julian0821/KAIOS/CANSAT/DOCUMENTACION/CANSAT - KAIOS/PDR de terceros/PDR06.pdf

Team Logo
Here

# CanSat 2014 Preliminary Design Review (PDR) Outline

#5524

# ARISAT

### (ISTANBUL TECNICAL UNIVERSITY)

CanSat 2014 PDR: Team #5524 (Team ARISAT) | 1

# (If You Want) Presentation Outline

- Systems Overview | 6 (Hasbi Sevinç)

## - Sensor Susbsystem Design | 20 (Mert Kahyaoğlu)

- Descent Control Design | 29 (Nazmi Erdi COŞKUNPINAR)
- Mechanical Subsystem Deign | 39 (Ümit Yelken)
- Communication & Data Handling | 51 (Caner BALYEMEZLER)
- Electrical Power System Design | 62 (Emre Erbuğa)
- Flight Software Design | 76 (Emre Erbuğa)
- Ground Control Control System Design. | 83 (Ali Canpolat)
- Cansat Integration and Test | 90 (Ümit Yelken)
- Mission Operation and Analysis | 95 (Eren Durkaya)
- Requirements Compliance | 100 (Eren Durkaya)
- Management | 112 (Hasbi Sevinç)
Presenter: Hasbi Sevinç | CanSat 2014 PDR: Team #5524 (Team ARISAT) | 2

(If You Want) | Team ARISAT
Name | Year | Department
Hasbi Sevinc | Junior | Electronic and Communication Engineering
Ali Canpolat | Senior | Electronic and Communication Engineering
Eren Durkaya | Freshman | Astronautical Engineering
Caner Balyemezler | Senior | Electronic Engineering
Emre Erbuga | Freshman | Control Engineering
Umit Yelken | Junior | Mechanical Engineering
Mert Kahyaoglu | Junior | Electronic and Communication Engineering
Nazmi Erdi Coskunpinar | Junior | Astronautical Engineering
Presenter: Hasbi Sevinç | CanSat 2014 PDR: Team #5524 (Team ARISAT) | 3

# (If You Want) Team Organization

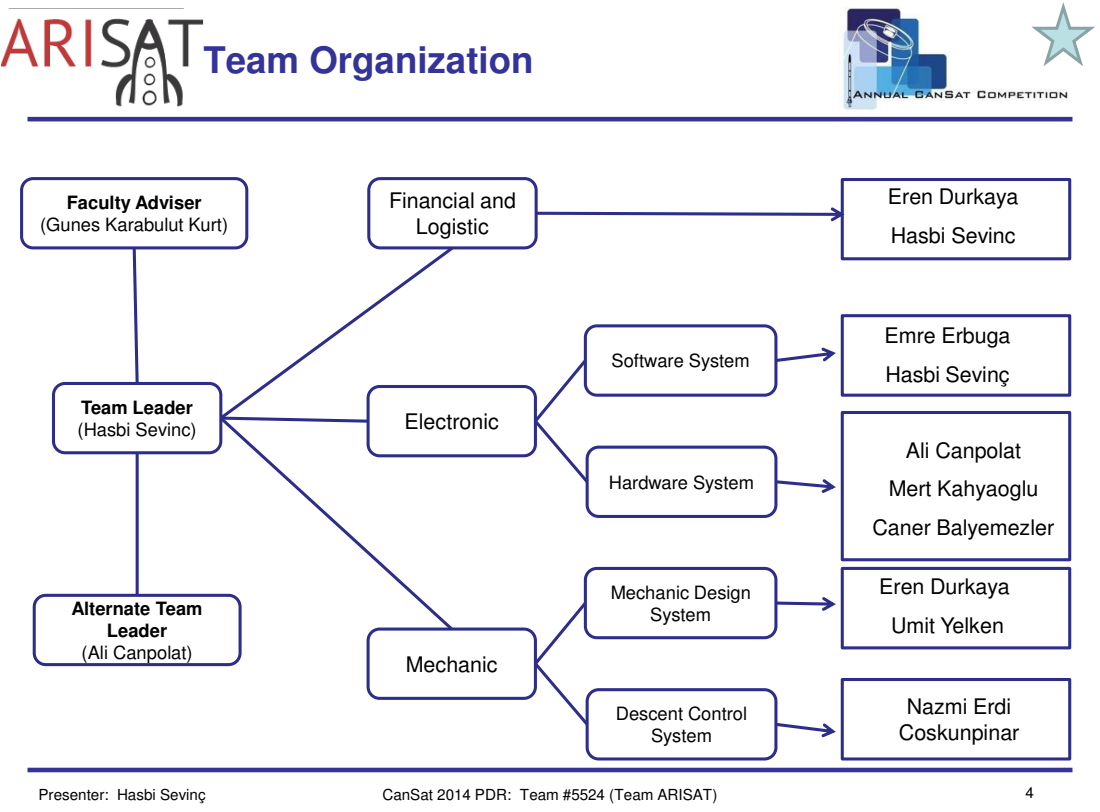
[picture p3: page 4]
Presenter: Hasbi Sevinç; CanSat 2014 PDR: Team #5524 (Team ARISAT); Team Leader (Hasbi Sevinc); Alternate Team Leader (Ali Canpolat); Financial and Logistic; Electronic; Mechanic; Software System; Hardware System; Mechanic Design System; Descent Control System; Eren Durkaya; Hasbi Sevinc; Emre Erbuga; Hasbi Sevinç; Ali Canpolat; Mert Kahyaoglu; Caner Balyemezler; Umit Yelken; Nazmi Erdi Coskunpinar

Faculty Adviser
(Gunes Karabulut Kurt)

(If You Want)

CanSat 2014 PDR: Team #5524 (Team ARISAT) | 5

# Acronyms

A – Analysis

ADC – Analog-to-Digital Converter

ADR – Average Descent Rate

ALT - Altitude
CDH – Communication & Data Handling

D – Demonstrate

DCD – Descent Control Design

DCS – Descent Control System

DS – Datasheet

EEPROM – Electrically Erasable Programmable Read-Only Memory
EPS – Electric Power System

F- Figure
FSW – Flight Software

GCS – Ground Control System

GPS – Global Positioning System

I – Inspect

I2C – Inter-Integrated Circuit

MSR- Mechanica System Requirements

SR-System Requirements
SSR – Sensor Subsystem Requirements

T – Test

TEM – Temperature

UART– Universal synchronous asynchronous receiver/transmitter
VM – Verification Matrix

Presenter: Hasbi Sevinç

# Systems Overview

# Hasbi Sevinç

CanSat 2014 PDR: Team #5524 (Team ARISAT) | 6

# (If You Want) Mission Summary

## The Main object:

- The 2014 mission simulates a sensor payload traveling through a planetary atmosphere sampling the atmospheric composition during descent.

## Other Objectives:

- Cansat shall collect data using sensors. (pressure, temperature, altitude…)
- Cansat shall transmit telemetry data’s to ground station.
- Protecting the egg.
- The descent rate of the CanSat shall be 12 m/s above 500 meters.
- Container shall release the payload at 500 meters.
- After releasing, the payload shall have a descent rate of less than 10 m/s.
- Payload must control descent rate without using parachute

## Bonus Objective:

- Use a three-axis accelerometer to measure the stability and angle of descent of the payload during descent. Sample at appropriate rate and store data for later retrieval.
- We decided to choose first bonus because measuring light intensity requires new subsystem. Our system already capable of measuring stability and angle of descent
Presenter: Hasbi Sevinç | CanSat 2014 PDR: Team #5524 (Team ARISAT) | 7

(If You Want) | System Requirement Summary
ID | Requirement | Rationale | Priority | Parent(s) | Children | VM
A | I | T | D
SRS-01 | Total mass of the CanSat shall not exceed 600 grams without the egg. | Competition Rule | HIGH | | MSR-01 | | X
SRS-02 | Cansat will be suited into cylindrical envelope at 125 mm diameter and 310 mm in length. | Competition Rule | HIGH | | MSR-04 | | X
SRS-03 | Payload suppose to harvest energy and also control descent rate without using parachute | Competition Requirement | HIGH | | EPS-01 | X X
SRS-04 | CanSat shall not use any flammable or pyrotechnic devices | Mission requirement to display real-time data. | HIGH | | DSC-02 | | X
SRS-05 | Cansat system and egg shall be recovered safely | Competition Rule | HIGH | | MSR-02 | | | X
Presenter: Hasbi Sevinç | CanSat 2014 PDR: Team #5524 (Team ARISAT) | 8

(If You Want) | System Requirement Summary
ID | Requirement | Rationale | Priority | Parent | Children | VM
A | I | T | D
SRS-06 | Cansat communication radio shall be the XBEE radio model and shall not use the broadcast mode | Competition Rule | HIGH | | CDH-01 | X | X
SRS-07 | Each team must use their own ground station | Competition Requirement | HIGH | | GCS -01 | | X
SRS-08 | All descent control systems must be capable of handling a 30G shock force | Competition Rule | HIGH | | DSC-06 DSC-07 | | X
SRS-09 | The cost of the Cansat shall not exceed $1000 USD. | Competition Rule | HIGH | | | X | X
SRS-10 | Use a three-axis accelerometer to measure the stability and angle of descent of the payload during descent | Bonus mission | MEDIUM | | SSD-04 | | | X
Presenter: Hasbi Sevinç | CanSat 2014 PDR: Team #5524 (Team ARISAT) | 9

(If You Want)

# System Level CanSat Configuration Trade & Selection

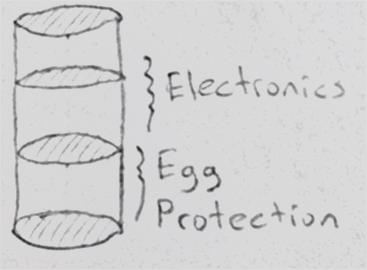
[picture p4: figure]

### - Round Design: First we consider a round design for payload, but this design ended up having area problem with energy harvesting system. We need to use flexiable solar panel which is unadaptable

for energy harvesting system.

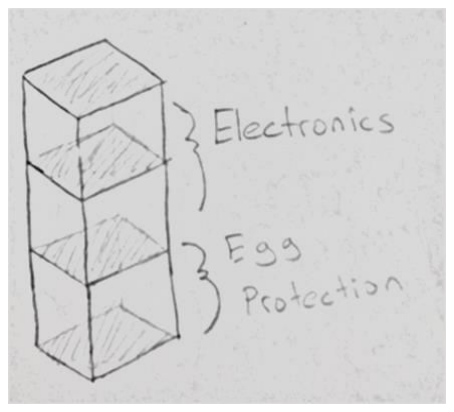
[picture p5: figure]

### - Square Design: Solar panels can be integrated easly, however this design could cause separation

problem between payload and container.

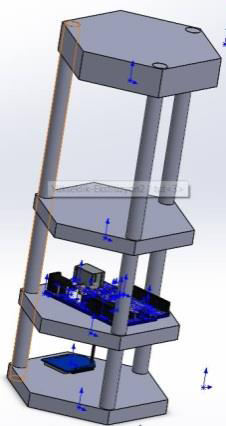
[picture p6: figure]

## - Hexagon Design (selected): This design

### provides enough area for electronic systems. Edge of hexagon has enough field to stick energy harvesting system. We think this is the best way for this years competition concept because harvesting

energy is a big deal for structure type.

Presenter: Hasbi Sevinç | CanSat 2014 PDR: Team #5524 (Team ARISAT) | 10

(If You Want)

# System Level CanSat Configuration Trade & Selection

- We decided to use carbon fiber as a material of lateral cover and base cover, because its light and sturdy against damages.

### - For Egg Protection: We have so many options for egg protection hence, we

### had narrow the options down. There was two 2 different material left for the tests: rubber and polyethylen-C70 composite sandwich structure foam. When we try to use rubber system we saw that rubber system is heavier than polyethylen-C70 composite sandwich structure foam system. Finally our egg

protection system is ready.

### - Separation : When we discussing about our separation system some thoughts

### came up for instance using a cap system, using a rail system, using a prestressed spring but they did not satisfied us we should not make any mistake

finally we compromise then we designed ring-clevis system.

Presenter: Hasbi Sevinç | CanSat 2014 PDR: Team #5524 (Team ARISAT) | 11

# (If You Want) System Concept of Operations

# Pre-launch

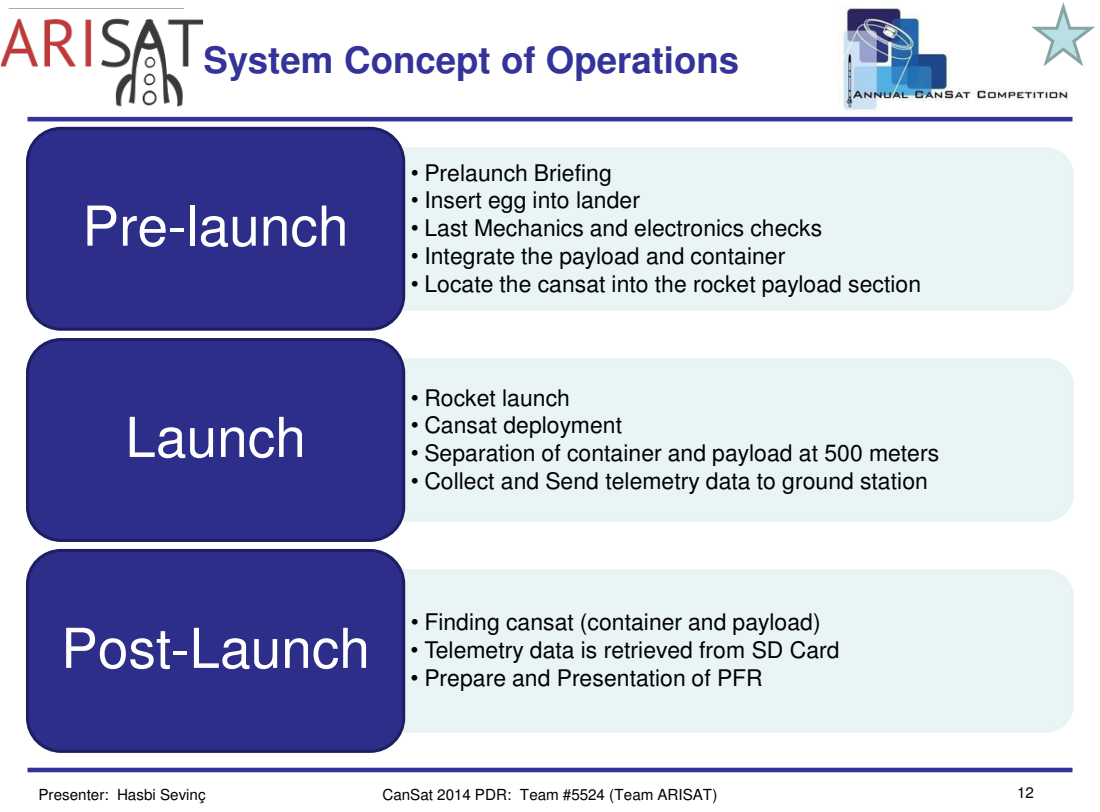
[picture p7: page 12]
Launch; Presenter: Hasbi Sevinç; CanSat 2014 PDR: Team #5524 (Team ARISAT)

• Prelaunch Briefing
• Insert egg into lander
• Last Mechanics and electronics checks
• Integrate the payload and container
• Locate the cansat into the rocket payload section

• Rocket launch
• Cansat deployment
• Separation of container and payload at 500 meters
• Collect and Send telemetry data to ground station

• Finding cansat (container and payload)

• Telemetry data is retrieved from SD Card Post-Launch

• Prepare and Presentation of PFR

(If You Want) | System Concept of Operations
| Launch and Descent Operations

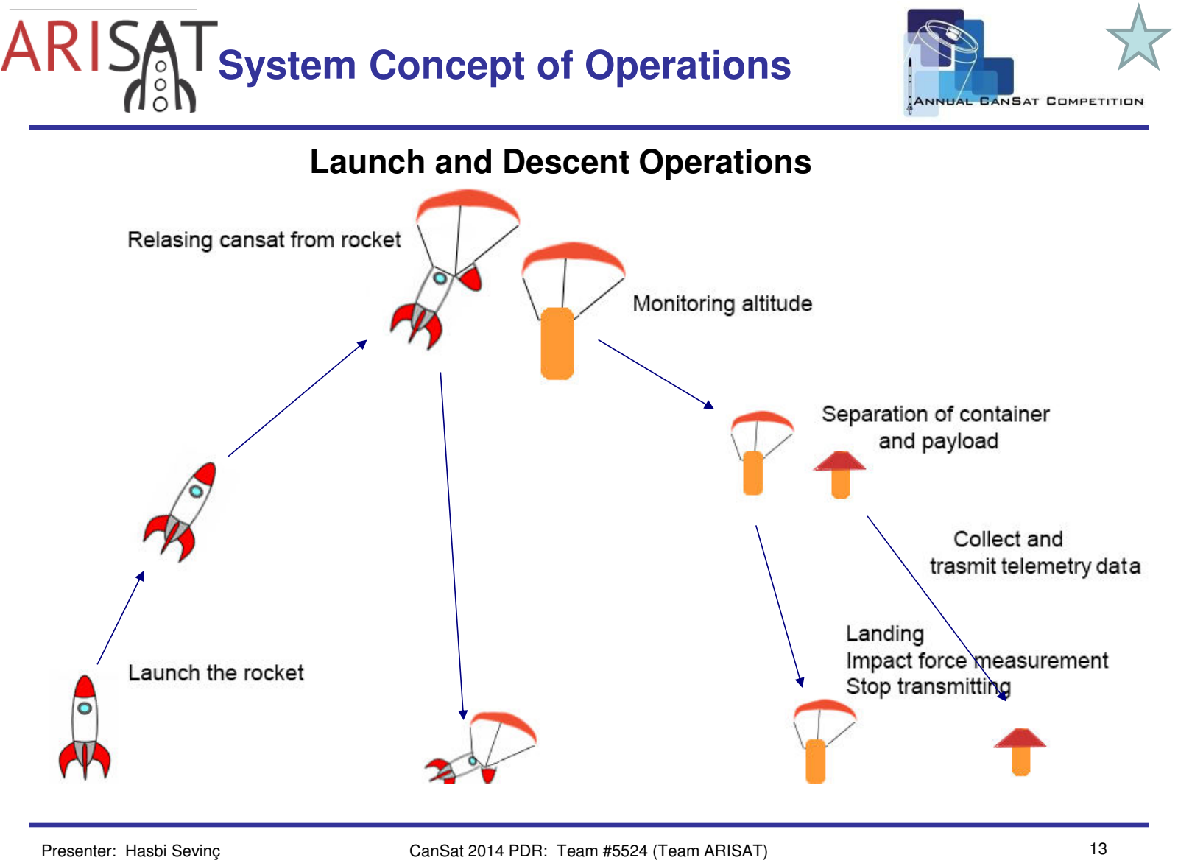
[picture p8: page 13]

Presenter: Hasbi Sevinç | CanSat 2014 PDR: Team #5524 (Team ARISAT) | 13

# (If You Want) System Concept of Operations

# Post-launch recovery

### - Find to landing location

### - Come back to ground station

### - Looking data which stored by payload via SD Card

# Post-launch data reduction

### - Infiltrate unpaired datas

### - Taking acceleration values

### - Compare ground station data with payload's for detect any differences

Presenter: Hasbi Sevinç | CanSat 2014 PDR: Team #5524 (Team ARISAT) | 14

(If You Want) | Physical Layout (Payload)

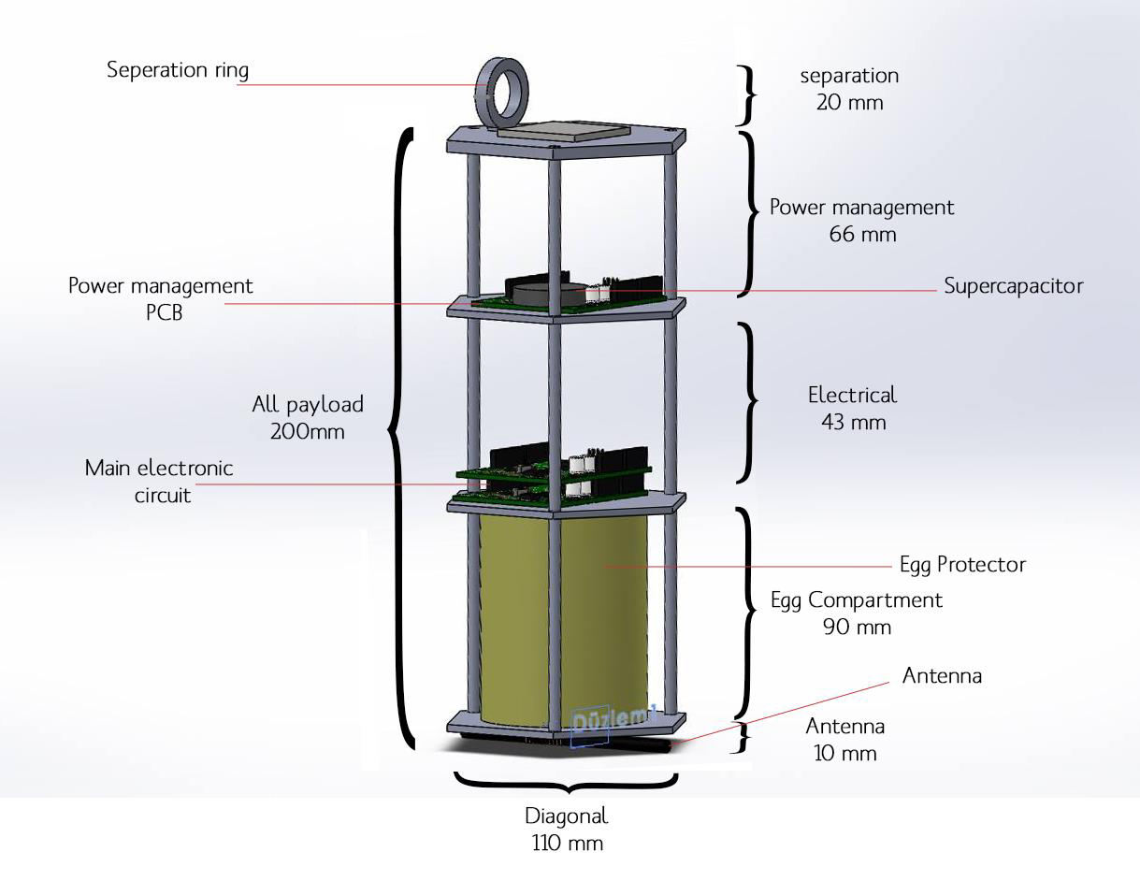
[picture p9: figure]

Presenter: Hasbi Sevinç | CanSat 2014 PDR: Team #5524 (Team ARISAT) | 15

(If You Want) | Physical Layout (Payload)

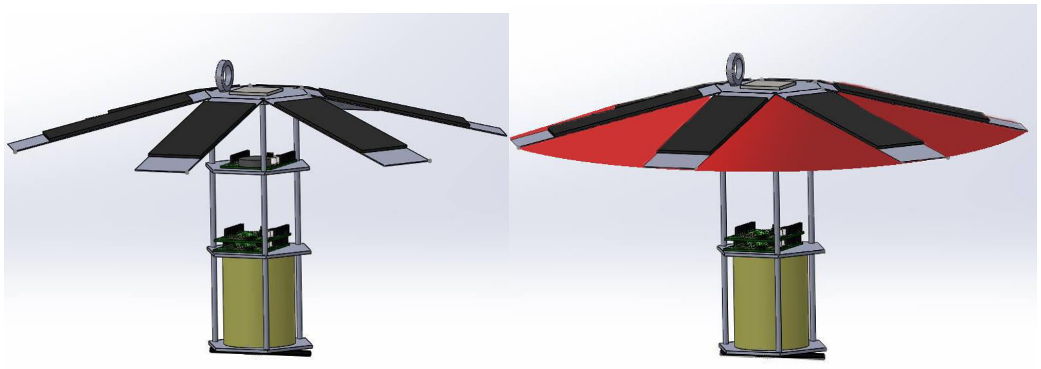
[picture p10: figure]

Presenter: Hasbi Sevinç | CanSat 2014 PDR: Team #5524 (Team ARISAT) | 16

## Payload with solar panels and descent system

# (If You Want) Physical Layout (Container)

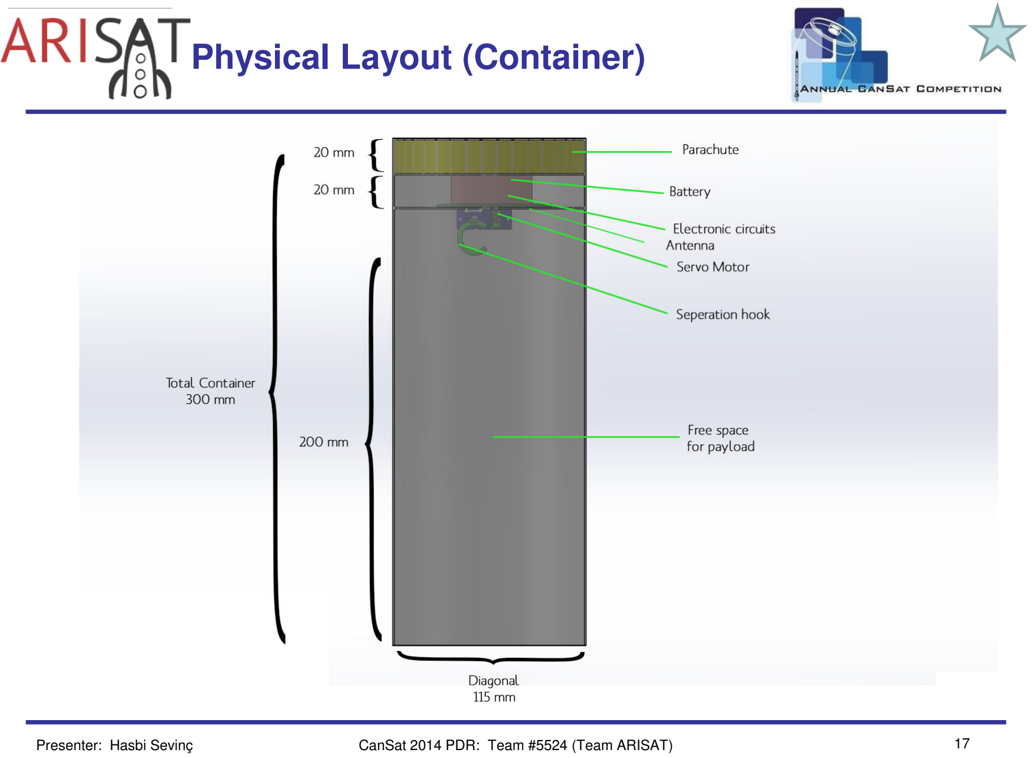
[picture p11: page 17]

Presenter: Hasbi Sevinç | CanSat 2014 PDR: Team #5524 (Team ARISAT) | 17

(If You Want) | Physical Layout (Payload + Container)

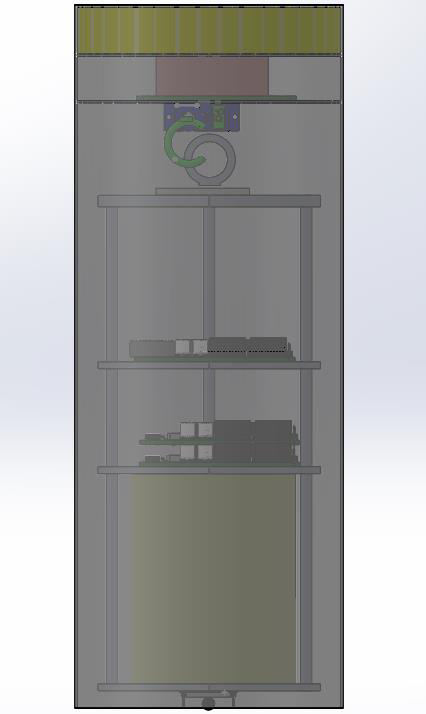
[picture p12: figure]

Presenter: Hasbi Sevinç | CanSat 2014 PDR: Team #5524 (Team ARISAT) | 18

(If You Want) | Launch Vehicle Compatibility

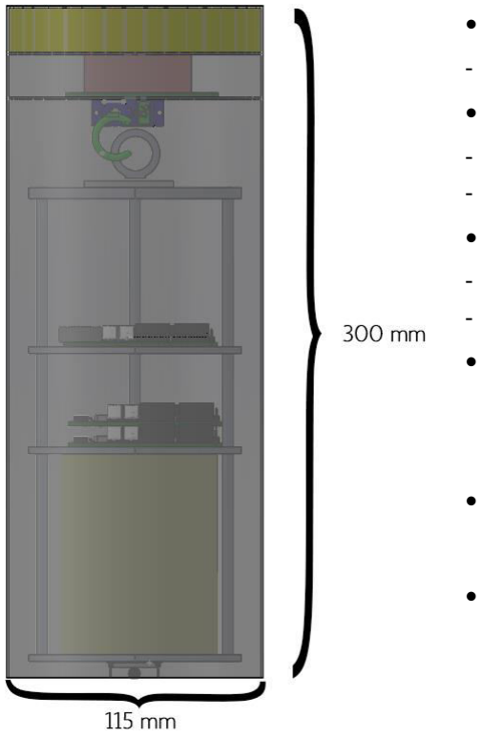
[picture p13: figure]

Presenter: Hasbi Sevinç | CanSat 2014 PDR: Team #5524 (Team ARISAT) | 19

## - Rocket payload dimensions:

- 125 mm x 310 mm

## - Cansat dimensions:

- Height: 300 mm
- Diameter: 115 mm

## - For a safety separation from rocket:

- leaving 5 mm of space on the top and bottom.
- leaving 5 mm of space on the left and right.

## - Cansat has a simple cylinder ic shape which disallowing any protrusions to

hinder ejection.

## - Before launch, cansat will test with a pre-built rocket payload model for verification - CanSat will be placed upside-down in rocket payload forDeployment from rocket correctly

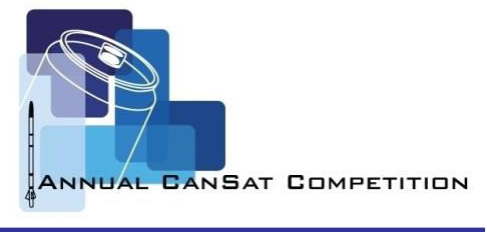
[picture p14: figure]

# Sensor Subsystem Design

# Mert Kahyaoğlu

CanSat 2014 PDR: Team #5524 (Team ARISAT) | 20

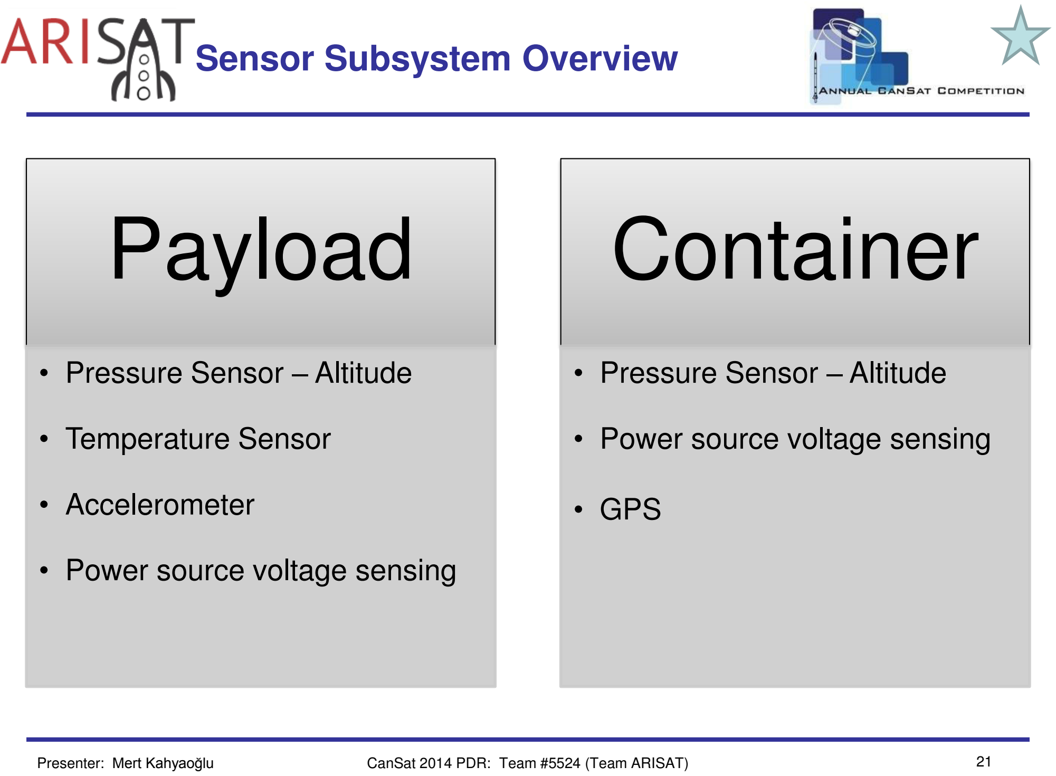
[picture p15: figure]
(If You Want); Sensor Subsystem Overview; Payload; • Pressure Sensor – Altitude; • Temperature Sensor; • Accelerometer; • Power source voltage sensing; Container; • GPS

Presenter: Mert Kahyaoğlu | CanSat 2014 PDR: Team #5524 (Team ARISAT) | 21

(If You Want) | Sensor Subsystem Overview
Sensor Type | Manufacture | Model | Purpose | CanSat use | Power Consumptioın
Pressure | Bosch | BMP-085 | Non-GPS Altitude measurement | Payload Container | 3.3v/5uA
Temperature | Bosch | BMP-085 | Temperature | Payload | 3.3v/5uA
Accelerometer | Analog Devices | ADXL345 | 3-Axis, ±2 g/±4 g/±8 g/±16 g Digital Accelerometer | Payload | 3.3v/40uA
Volt-meter | Atmel | Atmega2560 | Measurement of power source voltage | Payload Container | -
GPS | LOCOSYS Technology Inc | LS20031 | Descent Telemetry and determination of Landing | Container | 3.3v/41mA
Presenter: Mert Kahyaoğlu | CanSat 2014 PDR: Team #5524 (Team ARISAT) | 22

(If You Want) | Sensor Subsystem Requirements
ID | Requirement | Rationale | Priority | Parent | Children | VM
A | I | T | D
SSD-01 | Sensors must operate at 5V or less. | Our power system provide 5V or less | Medium | | EPS-05 EPS-04 | x
SSD-02 | All sensors must be able to sample data at a rate of at least 1 Hz | Base mission requirement | High | | FSW-01 | x | x
SSD-03 | Pressure sensor shall measure altitude with accuracy of at least 0.5 hPa | Base mission requirement | High | | | x | | x
SSD-04 | Accelerometer shall measure impact force at rate of at least 100 Hz | Base mission requirement | High | | | X
SSD-05 | Sensors shall use the following protocols: I2C, SPI, or Analog | Interface to Microcontroller | High | | | x | | X
Presenter: Mert Kahyaoğlu | CanSat 2014 PDR: Team #5524 (Team ARISAT) | 23

(If You Want) | Sensor Subsystem Requirements
ID | Requirement | Rationale | Parent | Children | Priority | VM
A | I | T | D
SSD-06 | Temperature sensor must have a range of at least 0ºC-50ºC | Air conditions of launch locatioın | High | | | x
SSD-07 | GPS Location data | Descent Telemetry and determination of Landing | High | | | x | x
Presenter: Mert Kahyaoğlu | CanSat 2014 PDR: Team #5524 (Team ARISAT) | 24

(If You Want) | Container GPS Trade & Selection
Model | Voltage/Current | Channel | Accuracy | Price | Weight
LS20031 GPS 5Hz Receiver | 3.3v/41mA | 66 | 3 | $59.95 | 14g
EM-408 | 3.3v/75mA | 20 | 10 | $60.00 | 16
MTK3339 10Hz | 3.3v/25mA | 20 | 2 | $39.95 | 8.5

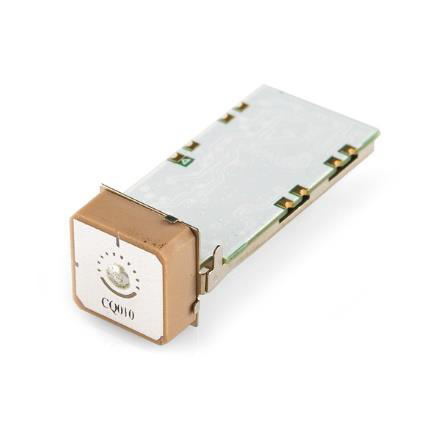
[picture p16: figure]

Presenter: Mert Kahyaoğlu | CanSat 2014 PDR: Team #5524 (Team ARISAT) | 25

LS20031 is selected, because;

### - Extremely compact - Internal antenna - High update rate - Low power consumption - Fast TTFF at low signal level

- Widely used, tested and examples.
- We use GPS therefore determination of container location after the landing.

(If You Want) | Altitude Sensor Trade & Selection
Model | Voltage/ Current | Range | Sample Rate(Hz) | Interface | Price | Weight
BMP085 | 3.3v/5uA | 30kPA-110kPa | 1 | I2C | $19.95 | 11g
SCP1000 | 3.3v/25u A | 30kPA-120kPa | 9 | SPI | $34.95 | 1.7g
MPL115A1 | 3.3v/10u A | 50kPa-115kPa | 1 | SPI | $11.95 | 2g

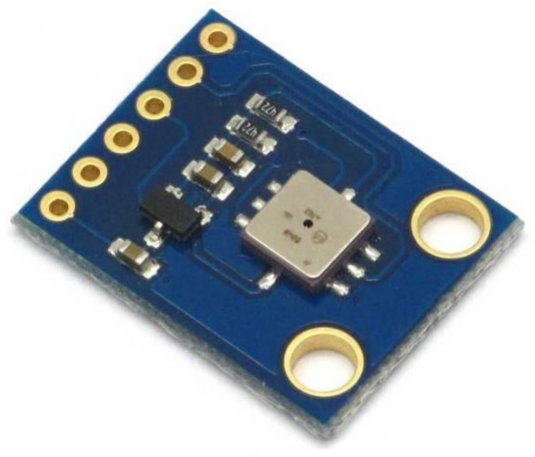
[picture p17: figure]

Presenter: Mert Kahyaoğlu | CanSat 2014 PDR: Team #5524 (Team ARISAT) | 26

BMP085 is selected for both payload and container.

### - Temperature measurement included - I2C interface - Fully calibrated

- Pb-free, halogen-free and RoHS compliant,

### - Ultra low power consumpiton - Altimeter accuracy of 0.25 [m] - Pressure Accuracy to ±0.2 [hPa]

(If You Want)

# Air Temperature Sensor Trade & Selection

Model | Voltage/ Current | Range | Sample Rate(Hz) | Interface | Price | Weight
BMP085 | 3.3v/5uA | -40º to +85ºC | 1 | I2C | $9.95 | 11g
SCP1000 | 3.3v/25u A | -20 to 70°C | 9 | SPI | $34.95 | 1.7g
MPL115A1 | 3.3v/10u A | -40°C to +105°C | 1 | SPI | $11.95 | 2g
DHT11 | 3.3v/200 uA | 0-50'C | 1 | Single Bus | $5.00 | 1.8g

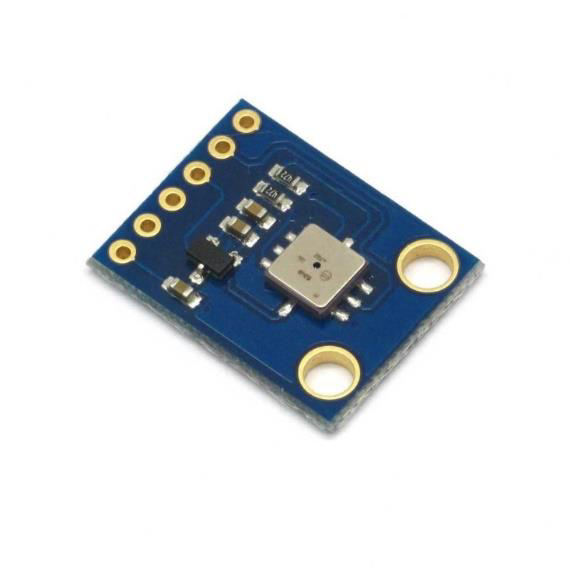
[picture p18: figure]

Presenter: Mert Kahyaoğlu | CanSat 2014 PDR: Team #5524 (Team ARISAT) | 27

### BMP085 is selected because:

### - Temperature measurement included - I2C interface - Fully calibrated

- Pb-free, halogen-free and RoHS compliant,

### - Ultra low power consumpiton - Temperature Accuracy to ±0.5 [ºC]

(If You Want)

# 3-Axis Accelerometer Sensor Trade & Selection

Model | Voltage/ Current | Range | Sample Rate(Hz) | Interface | Price | Weight
L3G4200D | 3.3v/6.7 mA | User Selectable ±250, ±500, ±2000 [dps] | 800Hz | I2C | $29.99 | 0.7 g
ADXL345 | 3.3v/40u A | ±1.5, ±16 [g] | 3200Hz | I2C/SPI | $27.95 | 5g
ADXL320 | 3.3v/450 uA | ±5 [g] | 500Hz | Analog | $40.85 | 3g

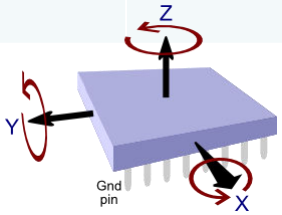
[picture p19: figure]

Presenter: Mert Kahyaoğlu | CanSat 2014 PDR: Team #5524 (Team ARISAT) | 28

### ADXL345 is selected because:

### - 2.0-3.6VDC Supply Voltage - Ultra Low Power: 40uA in measurement mode, 0.1uA in standby@ 2.5V - Tap/Double Tap Detection - Free-Fall Detection - SPI and I2C interfaces

# Descent Control Design

# Presenter: Nazmi Erdi COŞKUNPINAR

CanSat 2014 PDR: Team #5524 (Team ARISAT) | 29

(If You Want) | Descent Control Overview

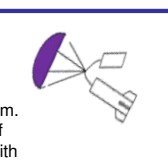
[picture p20: figure]
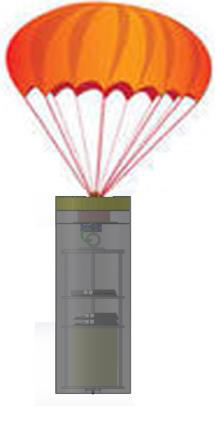
[picture p21: figure]
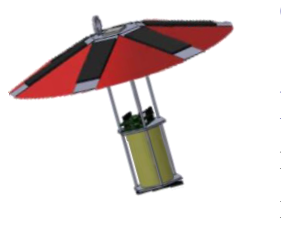
[picture p22: figure]

CanSat 2014 PDR: Team #5524 (Team ARISAT) | 30

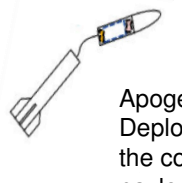
[picture p23: figure]

### 2. Boost and

Coast Phase
of Rocket

670 meters to 500 meters
contaier will descent with parachute at 12 m/s rate of velocity.

At 500 meters altitude
payload will deploy from
container. | From | 500
meters to ground the
descent rate must be 10
m/s .At this point the solar panels will open with
angle of 46.10 degree.
Solar panels are attached
to shells. Shells are
attached to each other
with parachute fabrics.

Apogee at 670 m.
Deploymeent of
the container with
payload.

The descent systems have two phases;

Container phase: Container phase has two critical point.

a) 670 meters to 500 meters altitude descent rate.

b)500 meters to ground drift range
According to these phases, the descent device and its properties must chosen compatible for both two critical point.

Payload Phase: Payload should have 10 m/s descent rate. Passive descent device is not permit to. Because of this situation a hybrid design of Aerobrake umbrella design were considered.

Presenter: Nazmi Erdi COŞKUNPINAR

(If You Want) | Descent Control Requirements
Number | Requirement | Rational | Priority | Parent | Children
A | I | T D
DSC - 01 | The CanSat (container and payload) shall deploy from the rocket fairing section. | Base Requirement | High | | | x | x
DSC-02 | The descent control systems shall not use any flammable or pyrotechnic devices. | Base Requirement | High | SRS-04 | | x | x
DSC-03 | The descent rate of the CanSat shall be 12 m/s above 500 meters. | Base Requirement | Medium | | | | x | x
DSC-04 | When the CanSat reaches 500 meters, the payload shall be released from the container. | Base Requirement | High | | FSW-04 | | x
DSC-05 | When released, the payload shall have a descent rate of less than 10 m/s with a combined aerobrake and umbrella design. | Base Requirement | High | | | x | x
DSC-06 | All descent control device attachments shall survive 30 Gs of shock. | Base Requirement | High | SRS-08 | | | x
DSC -07 | All descent control devices shall survive 30 Gs of shock. | Base Requirement | High | SRS-08 | | | x
Presenter: Nazmi Erdi COŞKUNPINAR | CanSat 2014 PDR: Team #5524 (Team ARISAT) | 31

(If You Want)

# Container Descent Control Strategy Selection and Trade

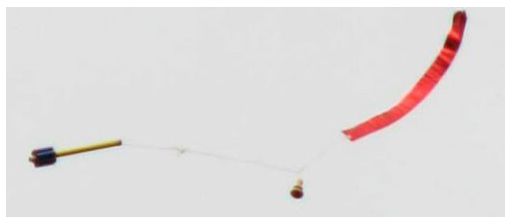
[picture p24: figure]

CanSat 2014 PDR: Team #5524 (Team ARISAT) | 32

Color selection : Orange
Shock Survivability: The staged parachute system can survive with 30g shock force. It can be tested in wind tunnel.
DCS connections: The parachute lines attached to top of the container.
Preflight review testability:
1)Shock force survivability of passive descent system will test behind of a car which has 20 m/s velocity.
2)The prototype of the system can be tested in wind tunnel.
3)Deploy from high buildings and plane or quadrotors.

### Option 1: Staged Parachute (Chosen) Advantages:

✓ Drag coefficient 1.5
✓ High stability,
✓ Compact
✓ Contrable

### Disadvadvantages:

✓ High wind drift potential

### Option 2: Streamer Advantages:

✓ Low Wind Drift Potential and simple

### Disadvantages:

✓ Drag Coefficient 0.14 – 0.4

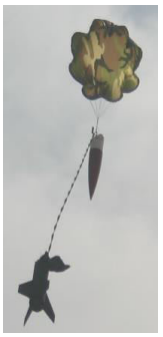
[picture p25: figure]

Presenter: Nazmi Erdi COŞKUNPINAR

# (If You Want) System Concept

✓ The parachute will open after deployment

✓ The first diameter has a fix value from 670 meters to 500 meters.

✓ After deployment of the payload from container at altitude of 500 meters, the weight of the

container to reduce 234 grams.
✓ Because of this situation the Radius of the sphere should reduce to 5 cantimeters. The

length of the scope is constant. Thus, we can change the angle between the scope and axis.
✓ To change the angle we can make some changings in line lengths.

✓ The all lines attached to each other with a point. This point atttached to a motor. When this

motor turns around its axis of mil. Thus the lines will close to each other and their lengths will reduce. Finally the value of the angle will reduce to considered value.
✓ With this system we keep the descent rate of the container after separation for minmum

drift.

Presenter: Nazmi Erdi COŞKUNPINAR | CanSat 2014 PDR: Team #5524 (Team ARISAT) | 33

# Payload Descent Control Strategy Selection and Trade

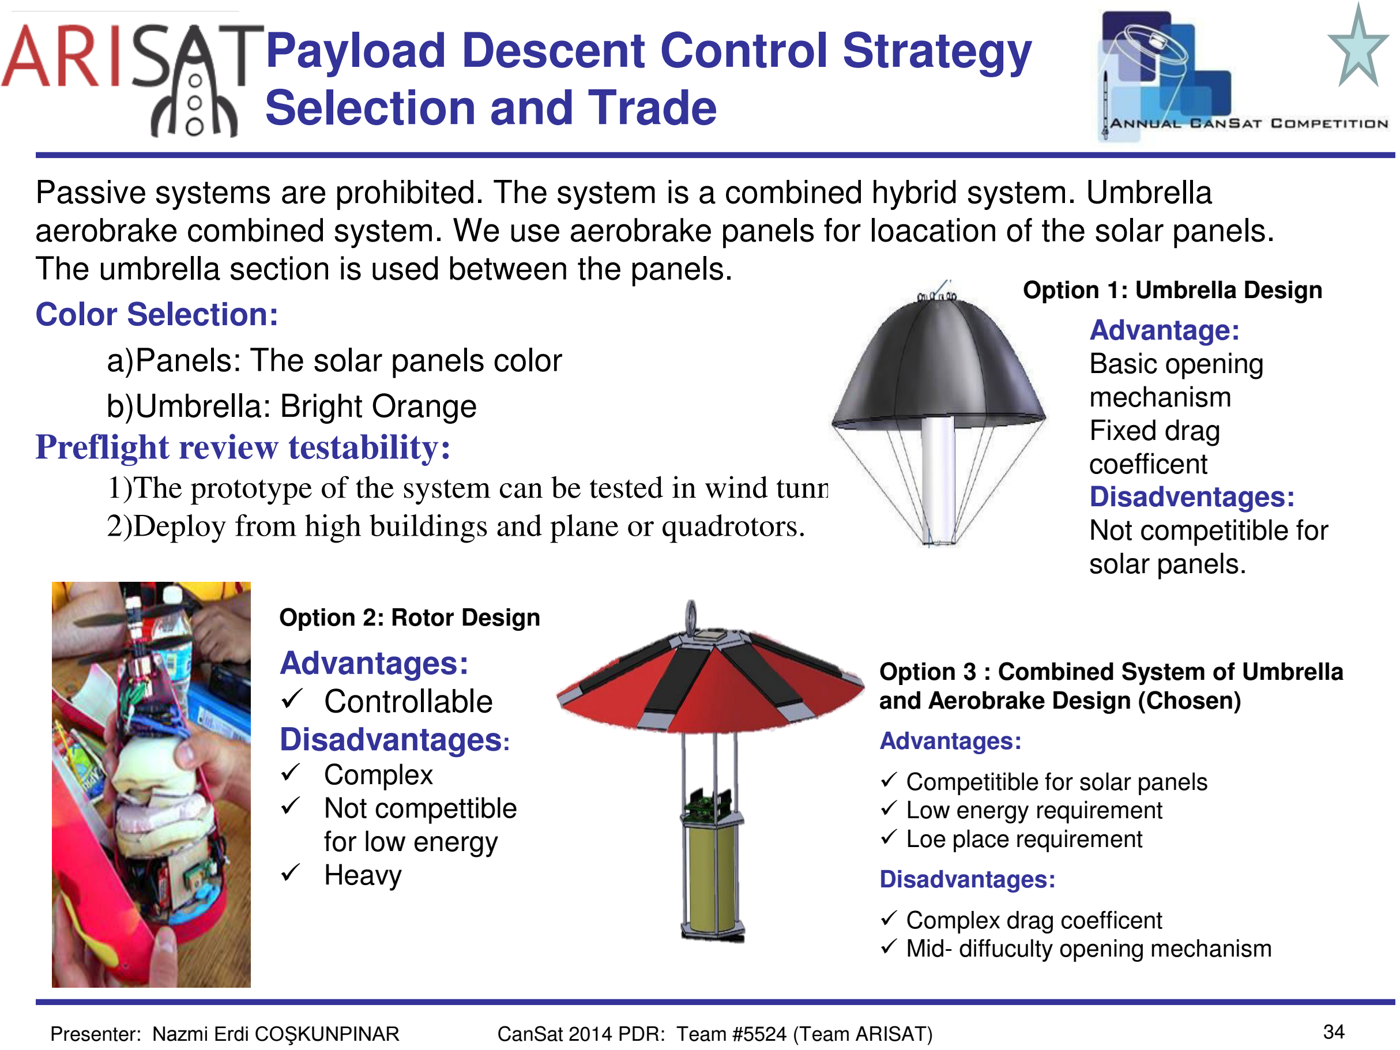
[picture p26: page 34]

(If You Want)

Passive systems are prohibited. The system is a combined hybrid system. Umbrella aerobrake combined system. We use aerobrake panels for loacation of the solar panels. The umbrella section is used between the panels.
Color Selection:
a)Panels: The solar panels color
b)Umbrella: Bright Orange
Preflight review testability:
1)The prototype of the system can be tested in wind tunnel. 2)Deploy from high buildings and plane or quadrotors.
CanSat 2014 PDR: Team #5524 (Team ARISAT) | 34

Option 1: Umbrella Design
Advantage:
Basic opening
mechanism
Fixed drag
coefficent
Disadventages:
Not competitible for
solar panels.

Option 2: Rotor Design
Advantages:
✓ Controllable

Disadvantages:
✓ Complex
✓ Not compettible

for low energy
✓ Heavy

Option 3 : Combined System of Umbrella and Aerobrake Design (Chosen) Advantages:
✓ Competitible for solar panels
✓ Low energy requirement
✓ Loe place requirement

Disadvantages:
✓ Complex drag coefficent
✓ Mid- diffuculty opening mechanism

Presenter: Nazmi Erdi COŞKUNPINAR

# (If You Want) System Concept

- The panels are closed in container
- The panels attached to cansats top lpate with high strong spring.
- The panels attached to cansats bottom plate with foldable sticks.
- When cansat separates from the container, the compressed string push the panels. The foldable sticks keep the angle between the cansat and panels.
- Thus requiement will be accomplished with zero electric energy and basic mechanic system.

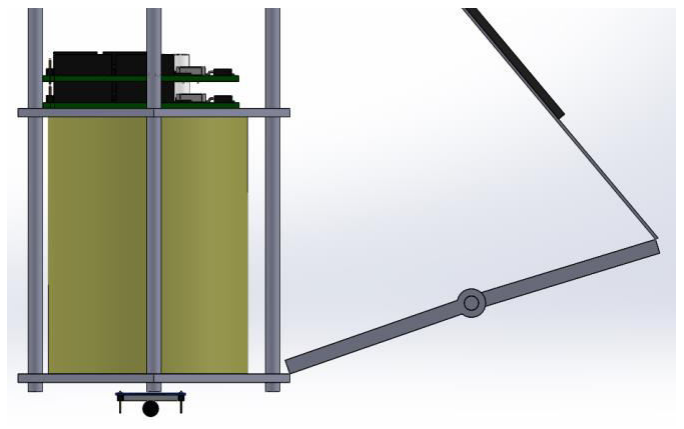
[picture p27: figure]
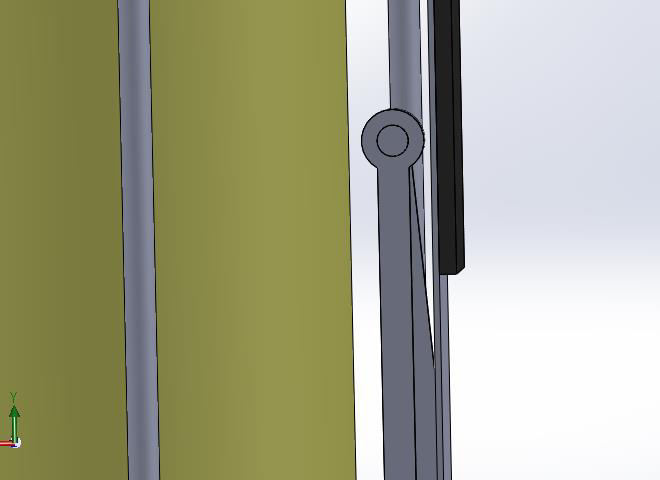
[picture p28: figure]
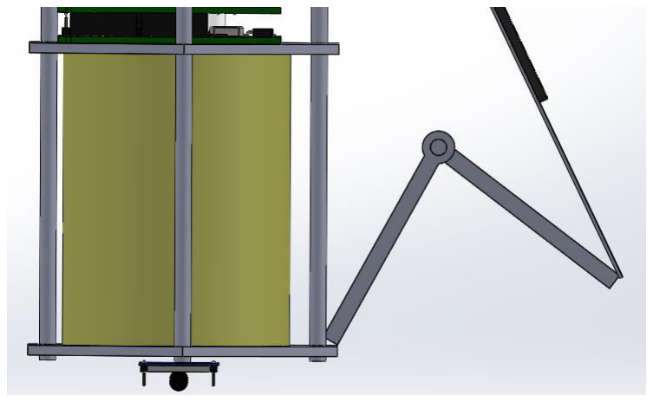
[picture p29: figure]

Presenter: Nazmi Erdi COŞKUNPINAR | CanSat 2014 PDR: Team #5524 (Team ARISAT) | 35

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

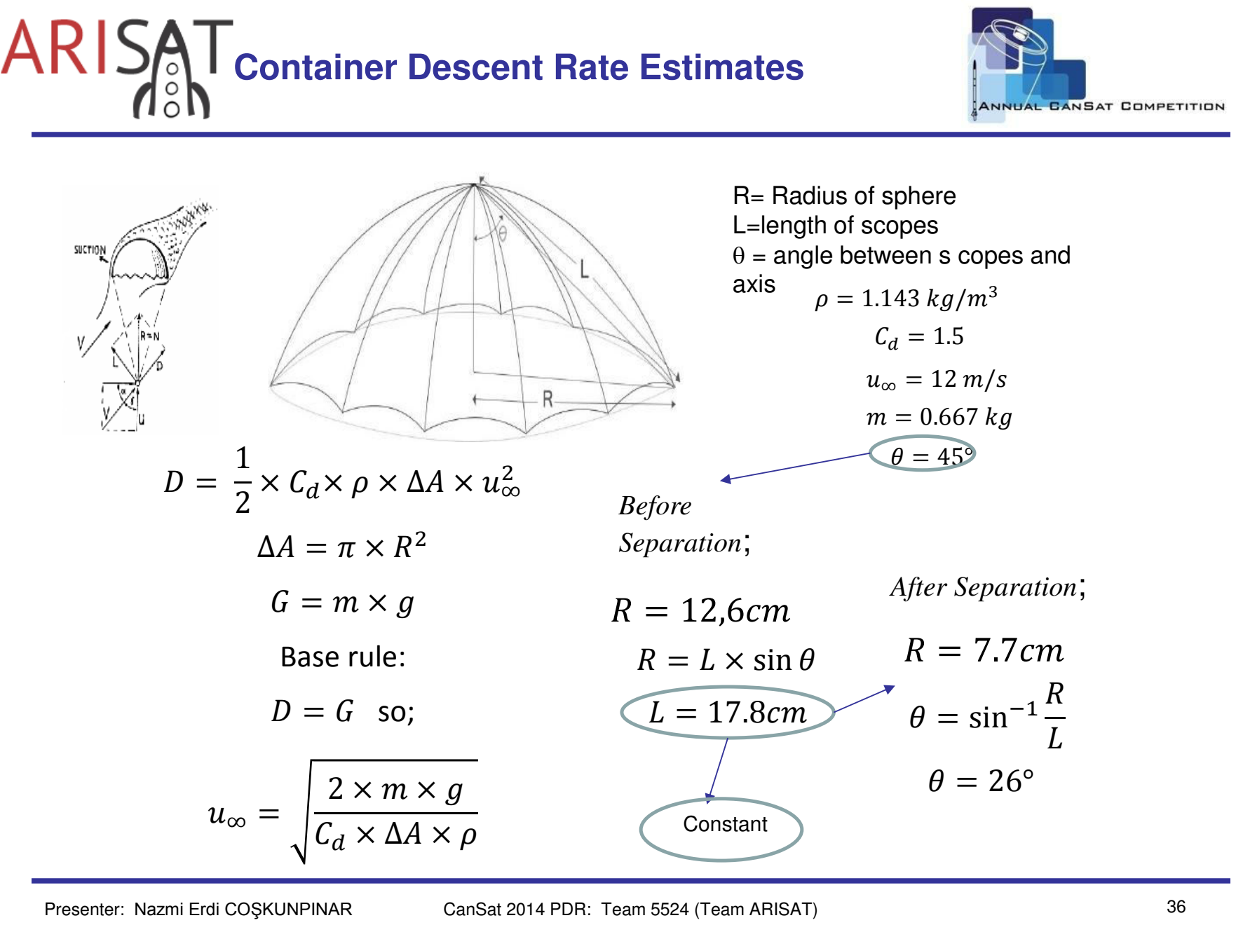
[picture p30: figure]

(If You Want) | Payload Descent Rate Estimates

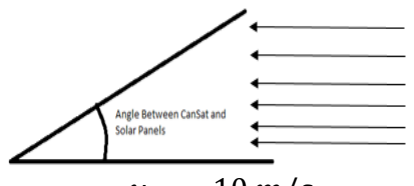
[picture p31: figure]

CanSat 2014 PDR: Team 5524 (Team ARISAT) | 37

∞ = /
∆ = × ×

# ∆ = × × × cos

= ×
= ܦ

∞ × ∆ × ߩ ×ܥ ×

Base rule:

;so = ܦ

# = cos− × ×

∞ × ∆ × ߩ × ܥ

If we calculate according to only aerobrake system, we can find angle between panels and cansat. We know the infinite velocity. It is

/. Thus the angle is;
= .°

Now we know the angle between panels and cansat. According to this, we add the area of umbrella section.

# ∆ = × ℎ × × cos

∆ = .

The velocity equation is;
∞ =

× ×

# cos × ߩ × × ܥ

Presenter: Nazmi Erdi COŞKUNPINAR

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

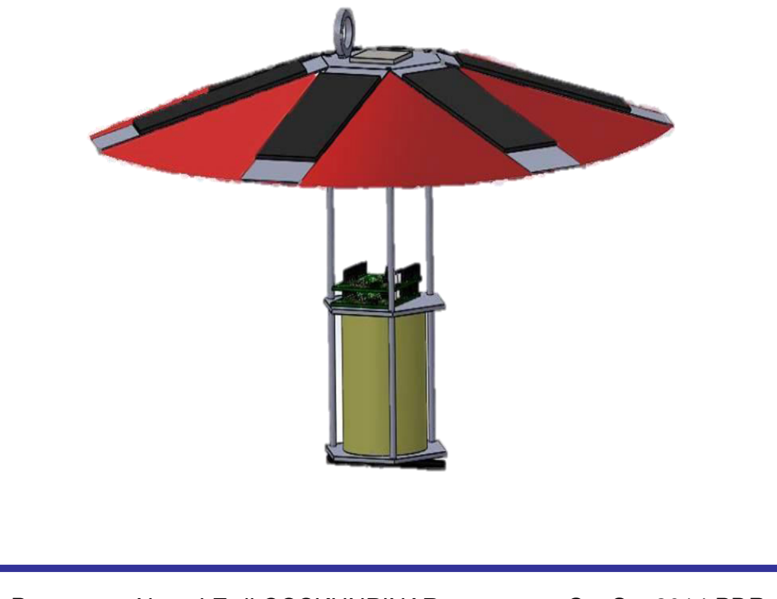
[picture p32: figure]

# Mechanical Subsystem Design

# Ümit Yelken

CanSat 2014 PDR: Team #5524 (Team ARISAT) | 39

(If You Want) | Mechanical Subsystem Overview

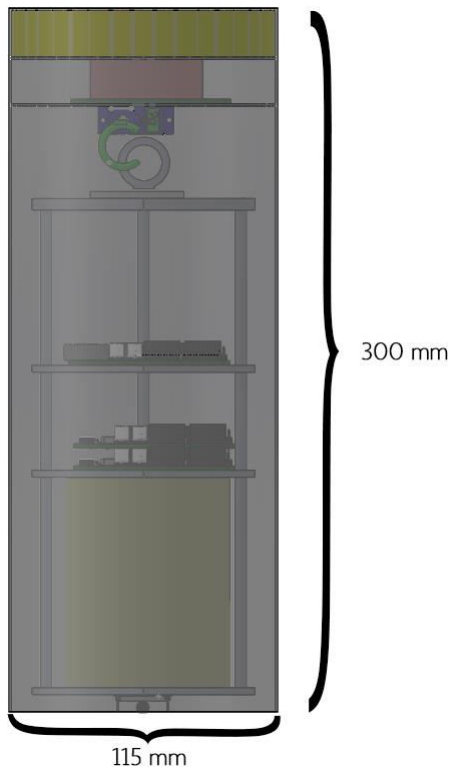
[picture p33: figure]

Presenter: Ümit Yelken | CanSat 2014 PDR: Team #5524 (Team ARISAT) | 40
- Container Structure:
- Cylinder PVC
- Bright Orange Color
- Basic Rail System to keep edge plates of the cansat closed.
- Container Electronic:
- Battery and circuitry allocated in top of the container.
- Separation System:
- Ring-Clevis System
- Payload Structure:
- Aliminium Screw Stick to attached the plates.
- | Carbon Fiber & Epoxy | Carbon Fiber Plates
- Glue
- Payload Electronic:
- Circuitry allocated in the mid in the payload and solar panels allocated
| on the edge of the payload.

## Egg Protection:

-Polyethylen and C70 Composite Sandwich Structure foam combined..

(If You Want)

# Mechanical Sub-System Requirements

ID | Requirement | Rationale | Priority | Parent | Children
A | I | T | D
MSR-01 | Total mass of the CanSat (container and payload) shall be 600 grams +/- 10 grams without the egg. | Mission Requirement | High | SRS-01 | | X
MSR-02 | The payload shall contain and protect the egg from cracking or breaking during flight through landing. The egg will weigh not more than 67 grams. | Payload section of the Rocket is limited | High | SRS-05 | | X | X
MSR-03 | The payload shall be completely contained in the container. No part of the payload may extend beyond the container. | Mission Requirements | Low | | | X
MSR-04 | Container shall fit in the envelope of 125 mm x 310 mm including the container passive descent control system. | Mission Requirements | High | SRS-02 | | X
Presenter: Ümit Yelken | CanSat 2014 PDR: Team #5524 (Team ARISAT) | 41

(If You Want)

# Mechanical Sub-System Requirements

ID | Requirement | Rationale | Priority | Parent | Children
A | I | T | D
MSR-05 | The container shall not have any sharp edges to cause it to get stuck in the rocket fairing section. | Mission Requirement | High | | | X | X
MSR-06 | The container shall be a florescent color, pink or orange. | Mission Requirements | High | | | | X
MSR-07 | The rocket airframe shall not be used to restrain any deployable parts of the CanSat | Mission Requirements | High
MSR-08 | The rocket airframe shall not be used as part of the CanSat operations | Mission Requirements | High | | | | X
Presenter: Ümit Yelken | CanSat 2014 PDR: Team #5524 (Team ARISAT) | 42

(If You Want) | Egg Protection Trade & Selection

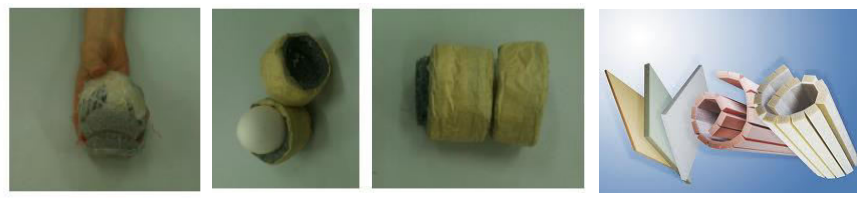
[picture p34: figure]

Presenter: Ümit Yelken | CanSat 2014 PDR: Team #5524 (Team ARISAT) | 43

### We have so many options for egg protection hence, we had narrow the options down. There was 2 different material left for the tests: rubber and C-70 Composite sandwich structure & polyethylen foam. When we try to use rubber system we saw that rubber system is heavier than polyethylen

combined foam system. Finally our egg protection system is ready.

(If You Want) | Egg Protection Trade & Selection
Presenter: Ümit Yelken | CanSat 2014 PDR: Team #5524 (Team ARISAT) | 44
Material | Density | Cost | Details | Pros | Cons
Memory Foam | 48-80 kg/m^3 | $20-150/ mattress topper | Rectangular foam 1.5 in thick | Soft, light | Susceptible to heat
Dough | unknown | $2-10 | Organic material with air pockets | cheap | Difficult to obtain consistent properties
Polyethylen | 0.910– 0.940 g/cm³ | $1-$2/Kg | Thermoplastic | Cheap, light | May get loose in container
Rubber | 1.1 kg/m^3 | 243.10 Cents/kg | petroleum by product | Easy for shaping | Heavy

### Chosen one Polyethylen:

- Resistant
- Inexpensive.
- Best performance in experiment.
- Energy absorbing capacity

(If You Want)

# Mechanical Layout of Components Trade & Selection

- Solar panels placed on the edge descent aerobrake plates of the cansat .
- Egg protection system placed on the bottom for wise payload integration.
- Ring-Clevis separation mechanism placed on top of payload in order to accomplish succesful separating.
- Servo Motor will be placed on the top of container to realize the separation.
- CanSats every single compartments material have chosen with rigor.

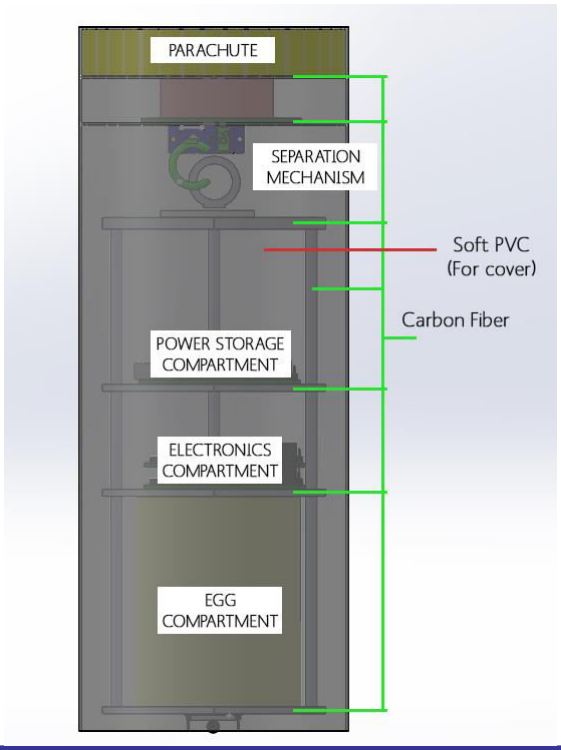
[picture p35: figure]

Presenter: Ümit Yelken | CanSat 2014 PDR: Team #5524 (Team ARISAT) | 45

(If You Want)

# Mechanical Layout of Components Trade & Selection

Presenter: Ümit Yelken | CanSat 2014 PDR: Team #5524 (Team ARISAT) | 46
Material | Cost ($/m^2) | Tensile Strength (MPa) | Density (kg/m^3) | Pros | Cons
Polyethylene | 12.20-47.94 | 41.2 | 1040 | light, cheap, easily molded | weaker then other options
Fiber Glass | 10-40 | 42.3 | 1120 | Light Strong | Low Tensile Strength
Carbon Fiber | 50-200 | 350 | 1330 | light, strong | expensive
Aluminum | 69-144 | 152-310 | 2700 | strong, relatively cheap | heavier then other choices,

## Material Chosen: Carbon Fiber

### - Light

### - Strong Enough

### - Expensive but work it

# (If You Want) Material Selections

## - Aliminium Screw Stick choosen:

- First we consider a carbon fiber stick.Because this type of sticks are most capable to shock force. But their production process has some problems, moreover ; their prices are high. The last one is aliminium screw stick.This meterial is used for building a cansat that is more stable and capable to shock force.

## - Carbon fiber and Epoxy:

- high strength
- high flexibility
- hard to machinability for carbon fiber but easy to machinability for epoxy
- very low weight
- we already have in our laboratory

## - Glue and pin bolt for assemble the parts

- Polyethhylene & C70 Foam Combined system for egg protection.
Presenter: Ümit Yelken | CanSat 2014 PDR: Team #5524 (Team ARISAT) | 47

# (If You Want) Container - Payload Interface

## - Ring-Clevis System Designed for Separation:

- This system is used for separation of payload and container at 500 m altitude.

### According to this system; the ring attached to servo motor. When the servo

motor turned, the ring will release the payload which has a clevis on top. Thus; at 500 m altitude the payload and container will separate.

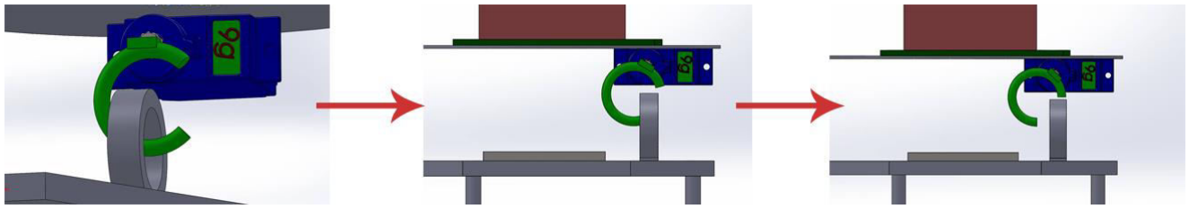
[picture p36: figure]

Presenter: Ümit Yelken | CanSat 2014 PDR: Team #5524 (Team ARISAT) | 48

### Servo motor is Turning

### payload and container separated

# (If You Want) Structure Survivability Trades

- For both Container and Payload ;
- We use printed circuit board for electronic component mounting method.In addition PCB to be mounted on hexagon carbon fiber plate.
- We cover our cansat with PVC Plates for prevent to particules spreading.

### - Acceleration and shock force requirements and testing: For these requirements

and testing we have some laborities. For instence; we can test our structure shock force capacibility tests our composite laboratory.

- Morover, we can test the our parachute and aerobrake systems in our Trisonic Laboratory wind tunnels.
- We use tape for securing of electrical materials.
- We have decided to connect our payload’s solar-wings with carbon plastic rod from the tip of the wing.
Presenter: Ümit Yelken | CanSat 2014 PDR: Team #5524 (Team ARISAT) | 49

(If You Want) | Mass Budget
Component | Mass(g) | Source
Frame | 50 | Estimate
RF Module | 11 | Datasheet
Microcontroller & PCB | 10 | Datasheet
Buzzer | 7 | Datasheet
Accelerometer | 1 | Datasheet
Super Capacitor | 12 | Estimate
Solar Panels x 6 | 180 | Datasheet
Temperature & Pressure (Altitude) Sensor | 2 | Datasheet
Egg Protection Material | 25 | Estimate
Egg | 67 | Given Information
Exterior Shell | 10 | Estimate
Other Mechanical Parts | 20 | Estimate
Payload Total | 395 | (With egg)
CanSat 2014 PDR: Team #5524 (Team ARISAT) | 50
Component | Mass(g) | Source
Frame | 25 | Estimate
Parachute | 80 | Estimate
Battery | 46 | Datasheet
RF Module | 11 | Datasheet
Microcontroller & PCB | 10 | Datasheet
GPS | 14 | Datasheet
Pressure (Altitude) Sensor | 2 | Datasheet
Exterior Shell | 10 | Estimate
Other Mechanical Parts | 20 | Estimate
Buzzer | 7 | Datasheet
Micro Servo Motor | 9 | Datasheet
Container Total | 234
Total Cansat Mass with egg (g) | Total Cansat Mass without egg (g)
629 gram | 562 gram

Presenter: Ümit Yelken

# Communication and Data Handling (CDH) Subsystem Design

# Presenter Name: Caner BALYEMEZLER

CanSat 2014 PDR: Team #5524 (Team ARISAT) | 51

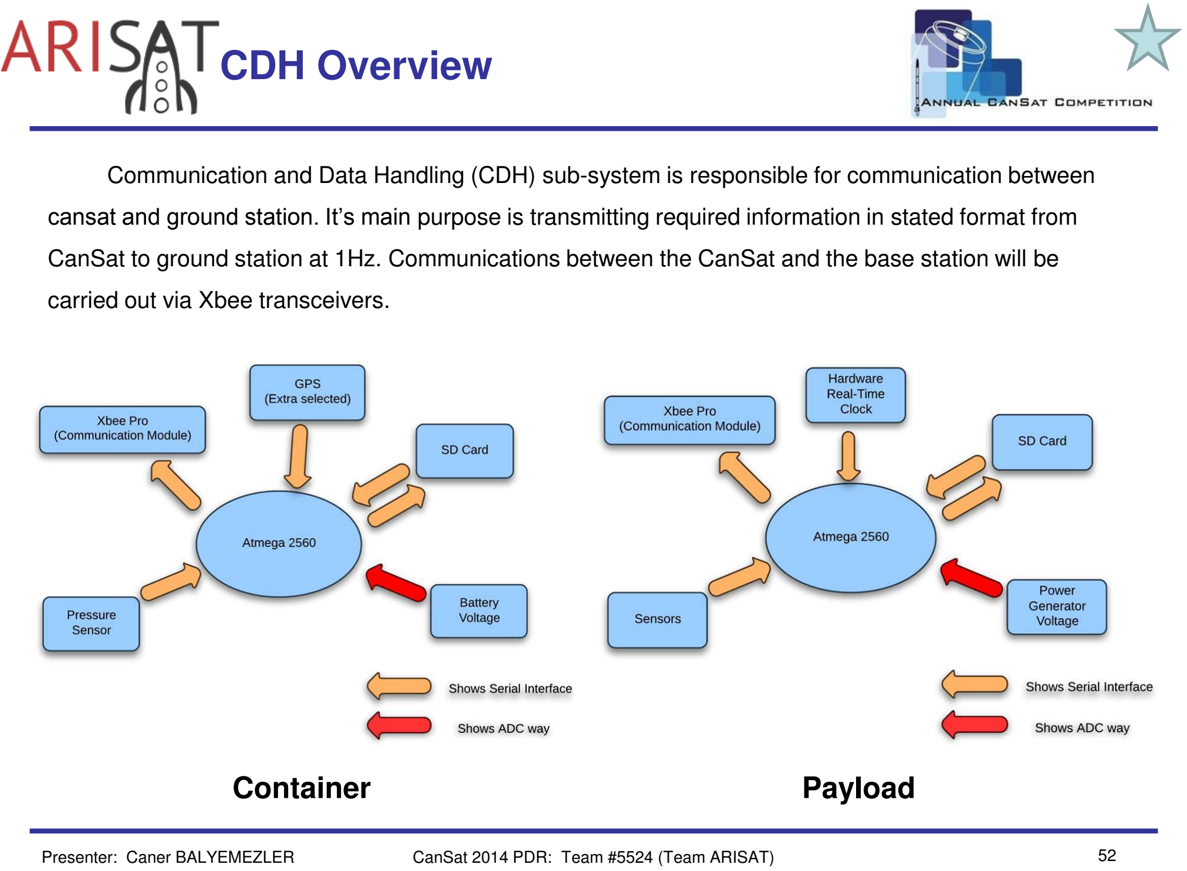
[picture p37: page 52]

(If You Want) CDH Overview

Communication and Data Handling (CDH) sub-system is responsible for communication between cansat and ground station. It’s main purpose is transmitting required information in stated format from CanSat to ground station at 1Hz. Communications between the CanSat and the base station will be carried out via Xbee transceivers.

Presenter: Caner BALYEMEZLER | CanSat 2014 PDR: Team #5524 (Team ARISAT) | 52
Container | Payload

(If You Want) | CDH Requirements
Presenter: Caner BALYEMEZLER | CanSat 2014 PDR: Team #5524 (Team ARISAT) | 53
ID | Requirement | Rationale | Priority | Parent(s) | Children | VM
A | I | T | D
CDH-01 | XBEE radios shall not use broadcast mode | Competition Rule | HIGH | SRS-06 | | | X
CDH-02 | XBEE radios shall have their NETID/PANID set to their team number | Competition Rule | HIGH | SRS-07 | | | X
CDH-03 | Organizing Sensor Data | Data must be suitable for Transmission | HIGH | SSD-02 | | | | X
CDH-04 | Telemetry packets shall transmit to GCS every second | Competition Rule | HIGH | | FSW-02 | | X
CHD-05 | Xbee Radio Shall have minimum range of at least 1km | Radio must stay in contact during the flight | HIGH | | | X | | X
CDH-06 | Communications shall terminate after CanSat landing | Competition Rule | HIGH | GCS -03 | | | X

(If You Want)

SPECIFICATION | 16f877 | 18f4550 | PIC18F46J50 | ATmega2560
Memory | 14 Kb | 32 KB | 64 KB | 644 KB
CPU Speed | 20MHZ | 48MHZ | 48MHZ | 16MHZ
RAM | 368 Byte | 2048 Byte | 3800 Byte | 8 Kbyte
ADC | 8 x 10 bit ADC | 13 x 10 Bit ADC | 13 x 10 Bit ADC | 6 x 10 Bit ADC
Operating Voltage | 2 – 5.5 V | 2 – 5.5 V | 2 – 3.6 V | 2.7-5.5 V
Price | 2.95 $ | 6.50 $ | 6 $ | 16 $
Advantage | Low Price | Low Operating Voltage | Low Operating Voltage | Low Power Consumption

# Processor & Memory Trade & Selection

Presenter: Caner BALYEMEZLER | CanSat 2014 PDR: Team #5524 (Team ARISAT) | 54

(If You Want)

# Processor & Memory Trade & Selection

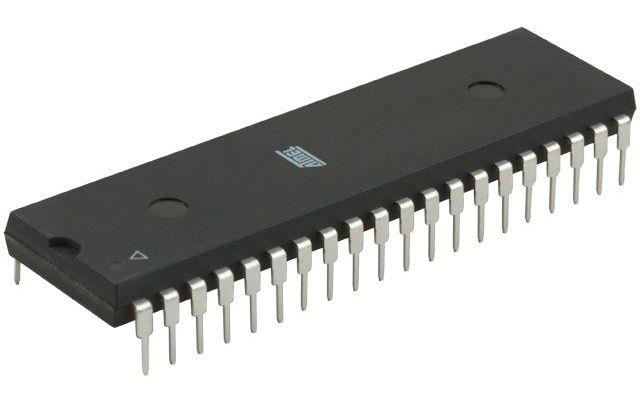
[picture p38: figure]

CanSat 2014 PDR: Team #5524 (Team ARISAT)

55

### CHOSEN DEVICE: ATmega2560

### Atmega2560 Advantages

### High flash program memory High internal SRAM High EPPROM capacity Easy to use More reliable

### Atmega2560 Disadvantages

### More expensive

Presenter: Caner BALYEMEZLER

# (If You Want) Real-Time Clock

- Hardware real-time clock will be used for both payload and container.

## - Because, if the system has no power to run (or reset), software clock

## could not show the real-time correctly. So that a hardware real-time

clock will be used.

## - İf the system will be reset, microcontroller check the real-time using with

hardware clock.

CanSat 2014 PDR: Team #5524 (Team ARISAT) | 56

### Features of Real Time Clock Module: - Two wire I2C interface - Hour : Minutes : Seconds AM/PM - Battery backup included - 1Hz output pin - 56 Bytes of Non-volatile memory

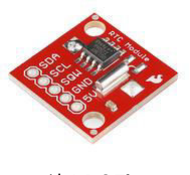
[picture p39: figure]

### available to user ($14.95)

Presenter: Caner BALYEMEZLER

(If You Want) | Antenna Trade & Selection
CanSat 2014 PDR: Team #5524 (Team ARISAT) | 57
SPECIFICATION | XBEE | XBEE-PRO
Indoor/Urban Range | 30m | 90m
Outdoor RF line-of-sight | 90m | 1600m
Transmit Power Output | 1mW | 63mW
RF Data Rate | 250000bps | 250000bps
Supply Voltage | 2.8V – 3.4V | 2.8V – 3.4V
Transmit Current (typical) | 45mA (@ 3.3 V) | 250mA (@3.3 V)
Operating Frequency | 2.4GHz | 2.4GHz

### - CHOSEN MODUL: Xbee Pro

### XbeePro Advantages

### - Long Distance - Easy to communicate

Presenter: Caner BALYEMEZLER

(If You Want) | Antenna Trade & Selection

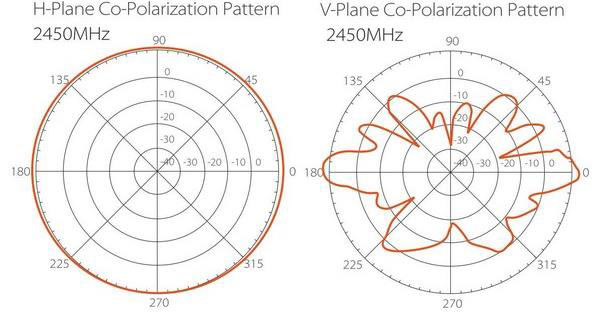
[picture p40: figure]

CanSat 2014 PDR: Team #5524 (Team ARISAT) | 58
SPECIFICATION | Tp-link TL-ANT2408CL | Tp-Link TL-ANT2405CL | 2.1dB Stock Xbee Antenna
Gain | 8 dB | 5 dB | 2.1 dB
Type | Omnidirectional | Omnidirectional | Omnidirectional
Size | 1.3x25 cm | 1.3x19 cm | 1.3x10 cm
Price | 5.3 $ | 2.9 $ | 2 $

We choose stock Xbee antenna because;
- it is a small antenna in size
- comes free with xbee pro

## CHOOSEN ANTENNA: stock xbee antenna

Presenter: Caner BALYEMEZLER

### 2.4 GHz wireless coverage range: 600-900 m

Radiation pattern of Stock Xbee Antenna (depending on the output power)

(If You Want) | Radio Configuration

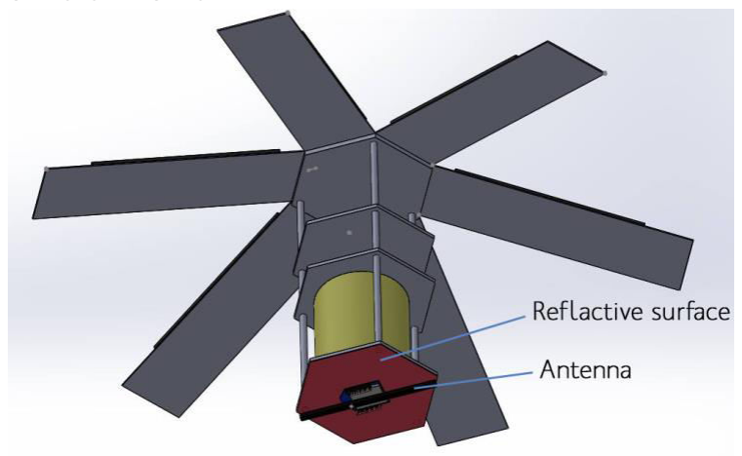
[picture p41: figure]

Presenter: Caner BALYEMEZLER | CanSat 2014 PDR: Team #5524 (Team ARISAT) | 59

XBP24-ZB RF Modules are configured by using X-CTU Configuration Tool. Steps of radio configuration are explained in a below
- XBEE Adapter is connected to PC USB port for radio configuration, after X-CTU Configuration Tool is run.
- Radios mission is selected by using program. Radio of GCS is configured as COORDINATOR AT and radio of CanSat is configured as ENDPOINT AT.
- Team number is entered PAN ID of COORDINATOR and ENDPOINT.
- Serial number is written SH and SL of ENDPOINT Device to Destination Adress DH and DL of coordinator.
- Serial number is written SH and SL of COORDINATOR Device to Destination Adress DH and DL of coordinator.
- XBP24-ZB RF Modules are ready to communications between them.

We placed xbee antenna under the payload so we
can get a clear view of ground station antenna. We
also use reflactive surface behind the antenna to reflect all the signals in one direction and achieve maximum range.

(If You Want) | Telemetry Format
CanSat 2014 PDR: Team #5524 (Team ARISAT) | 60

Included Data

–<TEAM_ID>
_<PACKET COUNT> - calculated by microcontroller –<MISSION_TIME> -Time as maintained by the MCU –<ALT_SENSOR> -Altitude as returned by non –<TEMP> -Air temperature
–< VOLTAGE > -Battery voltage
–< BONUS > -Current flight software state

Data Format

–Each field is comma separated, packet terminated with carriage return
–Baud rate of 9600

<TEAM ID>,<PACKET COUNT>,<MISSION_TIME>,<ALT SENSOR>,<TEMP>,<VOLTAGE>, [<BONUS>]

Ex : <4934>,<0004>,<000102.1234>,<0600.25>,<30.123>,<05.234>,[<BONUS>]

Presenter: Caner BALYEMEZLER

(If You Want) | Telemetry Format
CanSat 2014 PDR: Team #5524 (Team ARISAT) | 61
DEFINITION | CHARACTERS | EXPRESSION OF CHARACTERS
UTC Time | HHMMSS.SfSf | H -Hour, M-Minute, S-Second , Sf-Fraction of second
Latitude of CanSat | DDMM.MMM | D –Degree , M- Minute
Longitude of CanSat | DDDMMM.MMM | D –Degree , M- Minute
Mean Sea Level Altitude of CanSat | HHHH.HH | H-Height (Meter)
Battery Voltage | VV.VVV | V -Volt
Air Temperature | T T .T T T | T -Temperature (Celcius)
Tracked Satellites | ZZ | Z-Number of satellites
Pressure | PPPPPP | P-Pressure (Pascal)
Altitude of CanSat via non GPS Sensor | HHHH.HH | H-Height (Meter)

Presenter: Caner BALYEMEZLER

# Electrical Power Subsystem (EPS) Design

# Emre Erbuğa

CanSat 2014 PDR: Team #5524 (Team ARISAT) | 62

(If You Want) | EPS Overview of Payload

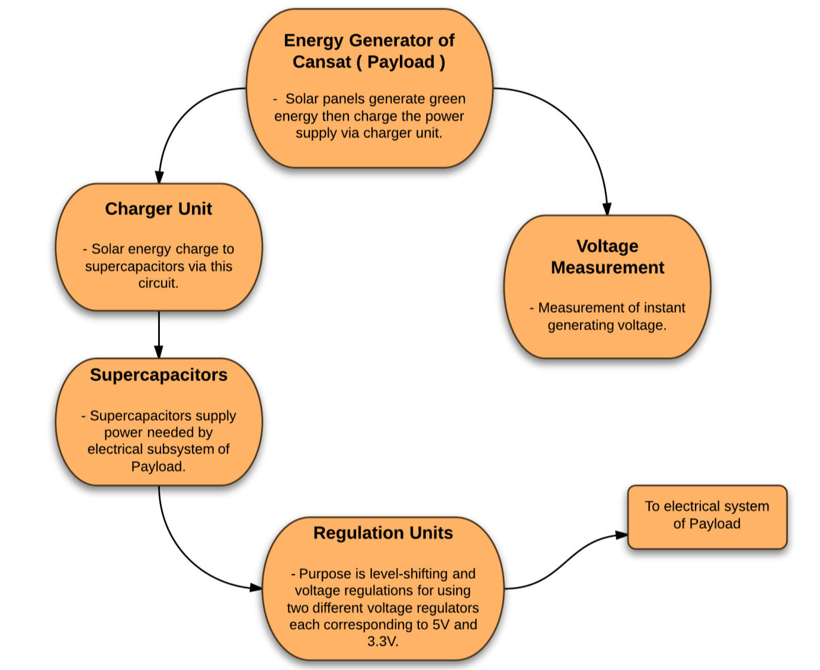
[picture p42: figure]

Presenter: Emre Erbuğa | CanSat 2014 PDR: Team #5524 (Team ARISAT) | 63

(If You Want) | EPS Overview of Container

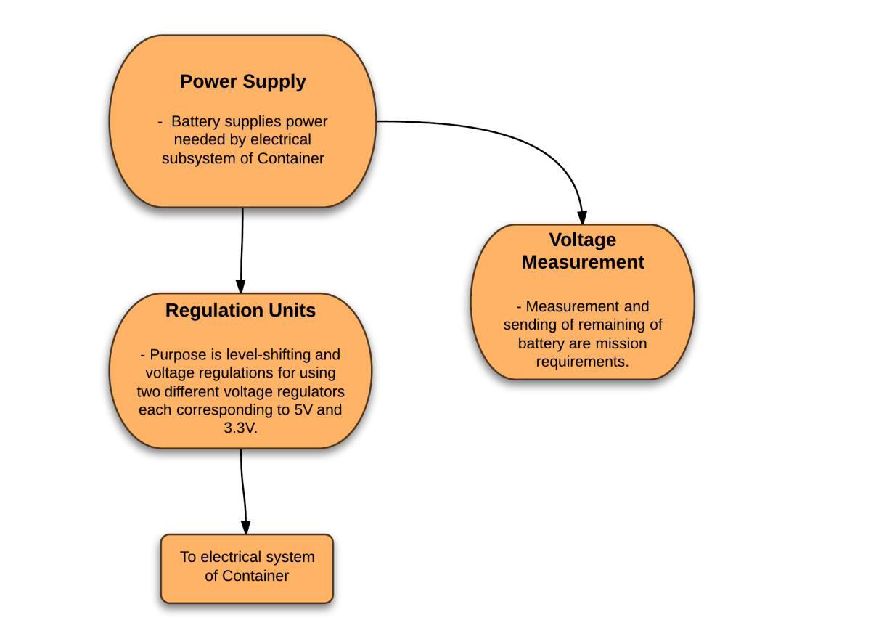
[picture p43: figure]

Presenter: Emre Erbuğa | CanSat 2014 PDR: Team #5524 (Team ARISAT) | 64

(If You Want) | EPS Requirements
Presenter: Emre Erbuğa | CanSat 2014 PDR: Team #5524 (Team ARISAT) | 65
ID | Requirement | Rationale | Priorit y | Parent(s) | Children | VM
A | I | T | D
EPS-01 | Energy harvesting with using solar panel (Payload). | Payload has no battery thus it needs energy generator. | HIGH | SRS-03 | | X X
EPS-02 | Entire components should be supplied with supercapasitors (Payload). | There is only one energy storage. | HIGH | | EPS-07 | | X X
EPS-03 | Entire components should be supplied with an only battery (Container). | There is only one voltage supply, battery. | HIGH | | | | X
EPS-04 | A 3.3v regulator must be used in Payload and Container. | Entire sensors use 3.3V | HIGH | SSD-01 | | | X

(If You Want) | EPS Requirements
Presenter: Emre Erbuğa | CanSat 2014 PDR: Team #5524 (Team ARISAT) | 66
ID | Requirement | Rationale | Priority | Parent(s) | Children | VM
A | I | T | D
EPS-05 | A 5v regulator must be used in Payload and Container. | Microcontrollers use 5v | High | SSD-01 | | | X
EPS-06 | Measure voltage with using microcontroller’s ADC. Resolution is 10 bits.(Payload,Container) | Base Mission Requirement | Medium | | | | X
EPS-07 | A charger unit (Payload) | Harvesting energy shall be charge to supercapacitors via this unit. | High | EPS-02 | | X | X
EPS-08 | Payload and Container shall have an accessible external switch. | Base Mission Requirement | Medium | | | | X

(If You Want) | Payload Electrical Block Diagram

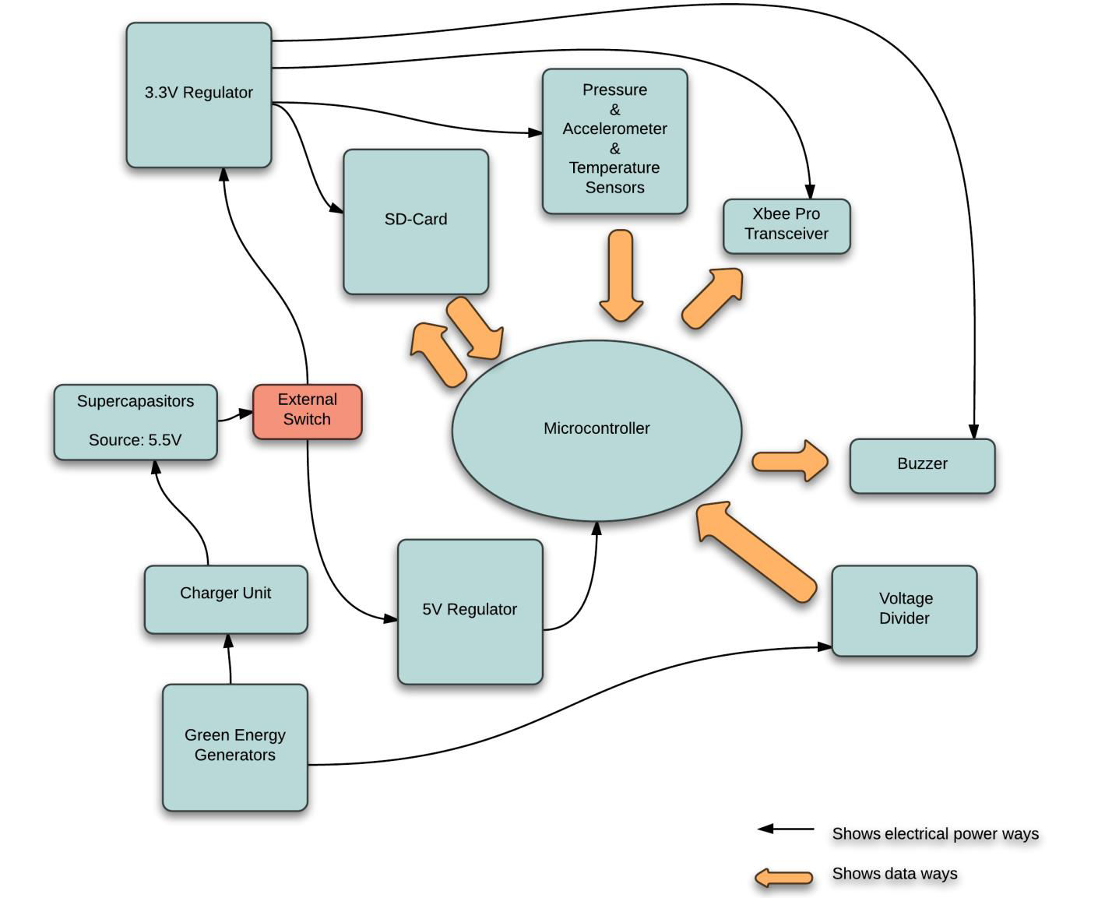
[picture p44: figure]

Presenter: Emre Erbuğa | CanSat 2014 PDR: Team #5524 (Team ARISAT) | 67

(If You Want) | Container Electrical Block Diagram

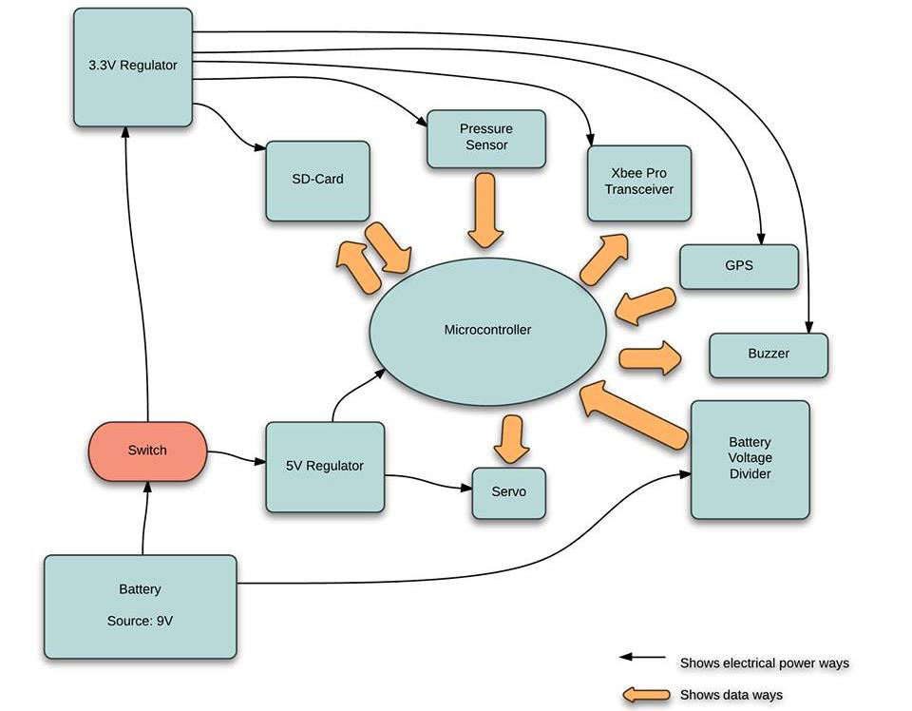
[picture p45: figure]

Presenter: Emre Erbuğa | CanSat 2014 PDR: Team #5524 (Team ARISAT) | 68

(If You Want)

Power source | Rationale | Voltage | Current | Energy Stroge | Weight | Source
Solar Panels | Solar panels are main power source of Payload. | ~6V | ~480mA | Supercapacitors will be charge via charger unit. | 30g X 6(pieces)= 180g | Estimation
Thermoelectric Generator *This datas will be occur at 100 Celcius differences. | Will NOT use | ~5.5V | ~500mA | Will NOT use | ~22g x 5(pieces)= 110g | Estimation
Wind power | Will NOT use | ~5V | ~100mA | Will NOT use | ~180g | Estimation

# Payload Energy Harvesting Strategy Trade Study

CanSat 2014 PDR: Team #5524 (Team ARISAT) | 69

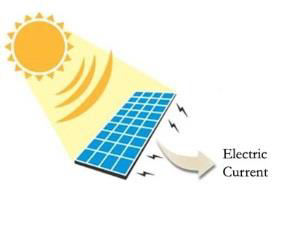
[picture p46: figure]

We chose solar energy for Payload’s main energy source, because;
- High proportion of Current/Weight
- Sufficient voltage
- Convenient environment for harvesting energy with this strategy

Presenter: Emre Erbuğa

(If You Want) | Payload Power Budget

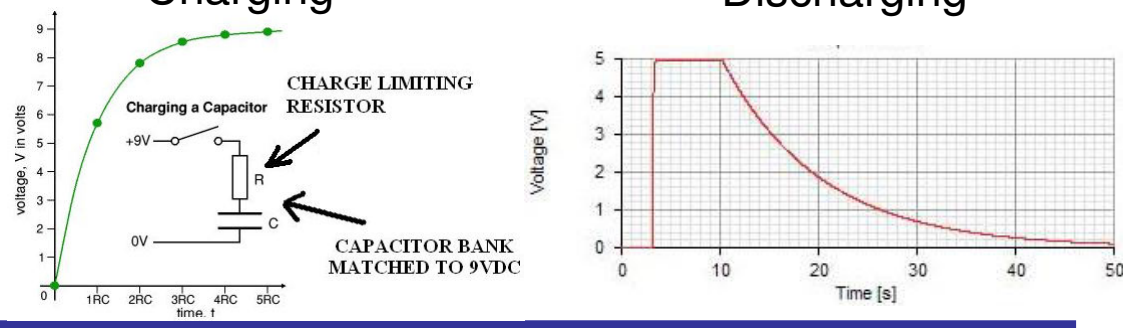
[picture p47: figure]

CanSat 2014 PDR: Team #5524 (Team ARISAT) | 70
Component | Voltage | Current | Power | Expected Duty Cycle(Time on in min.) | Uncertainty(±%) | total energy consumed | Source
Microcontroller | 5V | 10ma | 50mW | 60 | 20 | 50mWh | Datasheet
Pressure & Temperature Sensor | 3.3V | 5µA | 0.0165m W | 5 | 10 | 0.001mWh | Datasheet
Accelerometer Sensor | 3.3V | 40 µA | 0.132mW | 5 | 10 | 0.011mWh | Datasheet
SD-Card | 3.3V | 45mA | 148.5mW | 5 | 10 | 12.375mWh | Datasheet
Xbee Transceiver | 3.3V | 205mA | 676.5mW | 5 | 10 | 56.375mWh | Datasheet
Buzzer | 3.3V | 9mA | 29.7mW | 60 | 15 | 29.7mWh | Datasheet
Voltage Divider | - | - | Negligible | - | - | Negligible | Estimation
Total power consumed | ~269mAh(3.3v-5v)
Power sources | Solar Panels (6v)
Total power available | ~480mAh
Margins | ~211mAh

*Budget tables show total power consumption for an hour.

Presenter: Emre Erbuğa

Charging | Discharging

(If You Want) | Container Power Budget

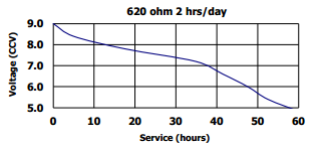
[picture p48: figure]

Presenter: Emre Erbuğa | CanSat 2014 PDR: Team #5524 (Team ARISAT) | 71
Component | Voltage | Current | Power | Expected Duty Cycle(Time on in min.) | Uncertainty(±%) | total energy consumed | Source
Microcontroller | 5V | 10mA | 50mW | 60 | 20 | 50mWh | Datasheet
Pressure Sensor | 3.3V | 5µA | 0.0165m W | 5 | 10 | 0.001mWh | Datasheet
SD-Card | 3.3V | 45mA | 148.5mW | 5 | 10 | 12.375mWh | Datasheet
Xbee Transceiver | 3.3V | 205mA | 676.5mW | 5 | 10 | 56.375mWh | Datasheet
Buzzer | 3.3V | 9mA | 29.7mW | 60 | 15 | 29.7mWh | Datasheet
GPS | 3.3V | 41mA | 135.3mW | 5 | 10 | 11.275mWh | Datasheet
Voltage Divider | - | - | negligible | - | - | negligible | Estimation
Total power consumed | ~310mAh(3.3v-5v)
Power sources | Alkaline Battery (9V)
Total power available | 615mAh
Margins | ~305mAh

*Budget tables show total power consumption for an hour.

Discharge of Energizer Hightech

(If You Want)

# Power Source Trade & Selection (Payload)

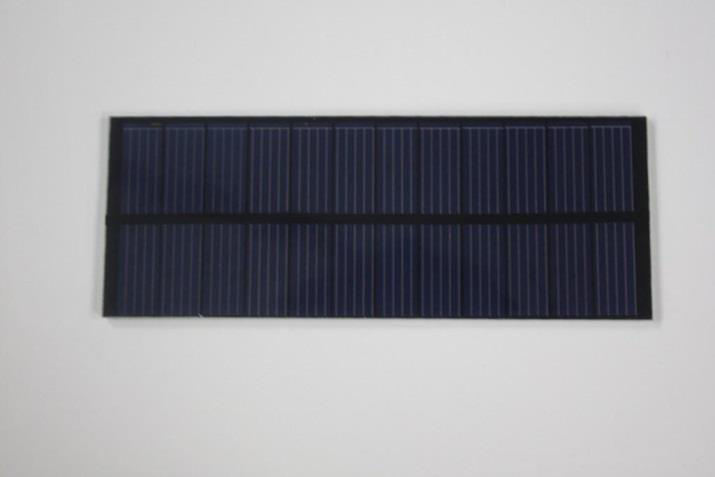
[picture p49: figure]

Presenter: Emre Erbuğa | CanSat 2014 PDR: Team #5524 (Team ARISAT) | 72
Brand | Voltage | Current | Max Power | Weight | Size(mm) | Price | Source
TEN | 6 V | 320 mA | 1.92W | 120g | 150x90x4 | $15.2 | Datasheet
OEM | 5.5V | 180 mA | 1w | 52g | 95x95x3 | $2.6 | Datasheet
Solar Pocket Factory | 6V | 165mA | 1w | 30g | 145x55x2.75 | $10 | Datasheet

We chose Solar Pocket Factory’s solar panels for Payload;
- Extremly light weight
- Sufficient voltage and current for system
- Suitable size for payload mechanism

## Solar Panel Trade & Selection

(If You Want)

# Power Source Trade & Selection (Container)

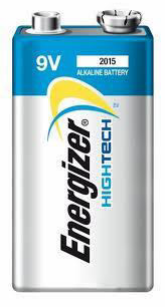
[picture p50: figure]

Presenter: Emre Erbuğa | CanSat 2014 PDR: Team #5524 (Team ARISAT) | 73
Brand | Type | Capacity | Weight | Voltage | Size(mm) | Price
Duracell duralock | Alkaline | 230mAh | 45 g | 9v | 17.5x26.5x48.5 | $4
U9VL-FP | Alkaline | 360mAh | 44.0g | 9v | 17.5 x 26.5 x 48.5 $4.48
Energizer HighTech | Alkaline | 615mAh | 46g | 9v | 17x26.2x48 | $3

We chose Energizer HighTech for Container;
- Low price
- Easily accesible battery
- High capacity
- Stabil at high current drain
- Suitable size

## Container Battery Trade & Selection

(If You Want) | Power Storage Trade & Selection

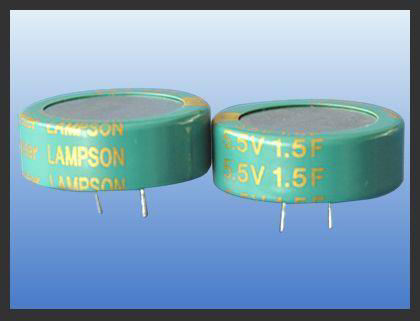
[picture p51: figure]

Presenter: Emre Erbuğa | CanSat 2014 PDR: Team #5524 (Team ARISAT) | 74
Brand | Nominal capacitance | MAX operating voltage | Weight | Price
KAMCAP | 0.50 F | 5.5V | 9g | $1.8
LAMPSON | 1.5F | 5.5V | 8.87g | $4

## SuperCapacitor Trade & Selection

While we choosing our payloads power source we all accept that we should use supercapasitors because they are non chemical components and also they have small weight. We have some experiments on them.

We chose Lampson’s supercapasitors for Payload ;
- High capacitance
- Low weight
- Quick charge and discharge

(If You Want)

# Power Bus Voltage Measurement Trade & Selection

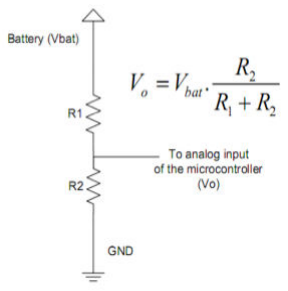
[picture p52: figure]

Presenter: Emre Erbuğa | CanSat 2014 PDR: Team #5524 (Team ARISAT) | 75

We will be using the microcontroller’s ADC to measure the voltage, which has a resolution of 10 bits. Will use high valued resistors (for low current drain and power consumption) to make a simple voltage divider and bring the voltage down from 9V max to 5V max. Because our microcontrollers can take maximum 5Volts as ADC input. Resistor values will be 250k(R2) and 200 k(R1).

We chose this way, because;

### - Easy way to divided voltage - Resistors were chose high because of low current drain - Compact and no extra weight(neiglieble)

# Flight Software (FSW) Design

# Emre Erbuğa

CanSat 2014 PDR: Team #5524 (Team ARISAT) | 76

(If You Want) | FSW Overview
CanSat 2014 PDR: Team #5524 (Team ARISAT) | 77
- Basic FSW architecture: Software in microcontroller monitors altitude and there is a timer

## code to send data’s to ground station and store in SD CARD. Two Atmega 2560

microcontrollers are used in container and payload. Microcontroller of container will generate GPS, pressure for altitude, RF and SD card. Microcontroller of payload will generate temperature, acceleration, pressure sensors for altitude, RF and SD card.
- Brief summary FSW tasks:
✓ Container collect altitude datas and transmit around the flight.
✓ Container shall release the payload the height of 500 meters.
✓ Read all sensors and prepare the data packet.
✓ The packets would be stored in SD card and trasmitted to ground station.
✓ If microcontroller restart , fsw will recover data and continue the mission requirements.
- Programming languages: C/C++
- Development environments: Arduino IDE

Presenter: Emre Erbuğa

(If You Want) | FSW Requirements
Presenter: Emre Erbuğa | CanSat 2014 PDR: Team #5524 (Team ARISAT) | 78
ID | Requirement | Rationale | Priority | Parent(s) | Children | VM
A | I | T | D
FSW-01 | Collection of sensors’ data in processor and formation of packet (Payload) | Reception of data values from sensors and analysis in firmware to generate data packets | High | SSD-02 | | | | X
FSW-02 | FSW shall transmit datapackets at a rate of 1Hz at least(Payload,Container) | At least 1 Hz telemetry shall be received from ground station. | High | CDH-04 | | | X
FSW-03 | Packets sent also stored as Data backup.(container,payload) | Packet also sent to SD-Card for Data backup | Medium | | | | X
FSW-04 | Control the release of Cansat at 500m (container) | So that the payload can be released at height of 500 meters | High | DSC-04 | | X | X

(If You Want) | FSW Requirements
Presenter: Emre Erbuğa | CanSat 2014 PDR: Team #5524 (Team ARISAT) | 79
ID | Requirement | Rationale | Priority | Parent(s) | Children | VM
A | I | T | D
FSW-05 | Collection of sensor data in processor and formation of packet ( container, payload) | Reception of data values from sensor and analysis in firmware to generate data packets | High | CDH-04 | | | X
FSW-06 | Baud rate of 9600 bps (container,payload) | To be able to send data’s regularly | Medium | | | X | X

# CanSat FSW State Diagram (Container)

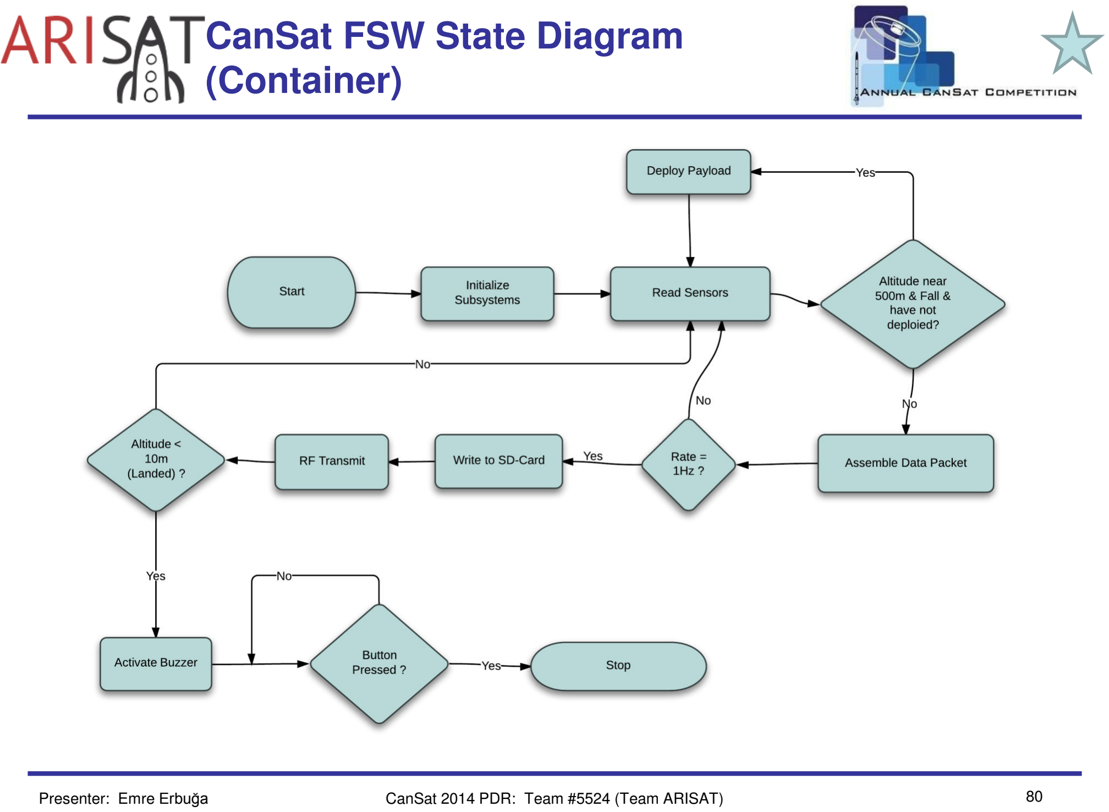
[picture p53: page 80]

(If You Want)

Presenter: Emre Erbuğa | CanSat 2014 PDR: Team #5524 (Team ARISAT) | 80

# CanSat FSW State Diagram (Payload)

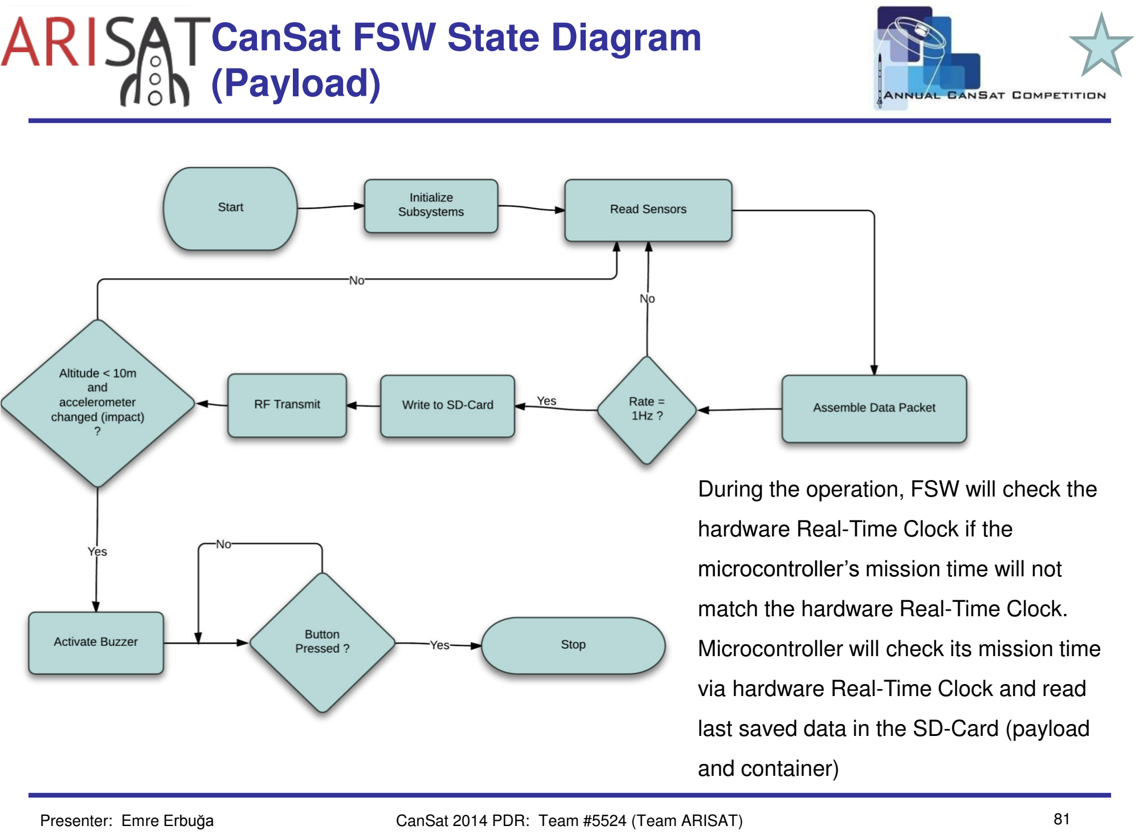
[picture p54: page 81]

(If You Want)

Presenter: Emre Erbuğa | CanSat 2014 PDR: Team #5524 (Team ARISAT) | 81

During the operation, FSW will check the hardware Real-Time Clock if the microcontroller’s mission time will not match the hardware Real-Time Clock. Microcontroller will check its mission time via hardware Real-Time Clock and read last saved data in the SD-Card (payload and container)

# (If You Want) Software Development Plan

- Flight software prototypes have been coded using the Arduino IDE .

### - Support for the radio transceivers will be coded first so that the microcontroller

### can communicate, sensors will be coded for and integrated into the system as

they are received.

### - Our software developers have their own projects on their area besides they

knowledge of c/c++, php, matlab programming languages.

### - The code will be tested as each sensor is integrated into the program.Then

integrated software will test.

### - Simulations will be run to approximate the conditions of the flight and possible

problems to ensure the software will run properly under all conditions.

Presenter: Emre Erbuğa | CanSat 2014 PDR: Team #5524 (Team ARISAT) | 82

# Ground Control System (GCS) Design

# Ali Canpolat

CanSat 2014 PDR: Team #5524 (Team ARISAT) | 83

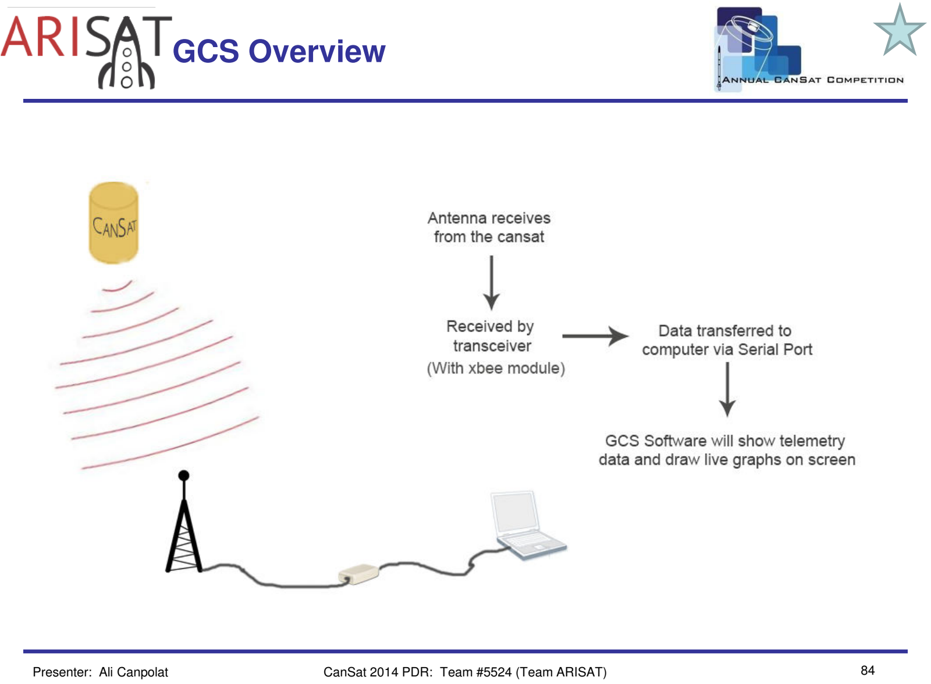
[picture p55: page 84]

(If You Want) | GCS Overview
Presenter: Ali Canpolat | CanSat 2014 PDR: Team #5524 (Team ARISAT) | 84

(If You Want) | GCS Requirements
ID | Requirement | Rationale | Priority | Parent(s) | Children | VM
A | I | T | D
GCS -01 | Our team have to have own GCS | Competition Rule | HIGH | SRS-07 | | | X
GCS -02 | GCS antenna shall be elevated a minimum of 3.5 m | Allows for clearer signal transmission | HIGH | | | | X
GCS -03 | GCS shall receive telemetry from the CanSat during flight | Competition Requirement | HIGH | | CDH-06 | | X
GCS -04 | GCS shall display and graph telemetry in real time | Mission requirement to display real-time data. | HIGH | | | X X
GCS -05 | GCS shall store telemetry data in a .csv file | Competition Rule | HIGH | | | X X
Presenter: Ali Canpolat | CanSat 2014 PDR: Team #5524 (Team ARISAT) | 85

(If You Want) | GCS Requirements
ID | Requirement | Rationale | Priority | Parent(s) | Children | VM
A | I | T | D
GCS -06 | Antenna of GCS must be towards CanSat for reduce to signal loss | Signal is affected by path loss and lose some power | HIGH | | | | X
GCS -07 | Antenna shall not have any interference | prevent signal loss | HIGH | | | | X
GCS -08 | All telemetry shall be displayed in engineering units | Competition Rule | HIGH | | | X | X
Presenter: Ali Canpolat | CanSat 2014 PDR: Team #5524 (Team ARISAT) | 86

(If You Want) | GCS Antenna Trade & Selection

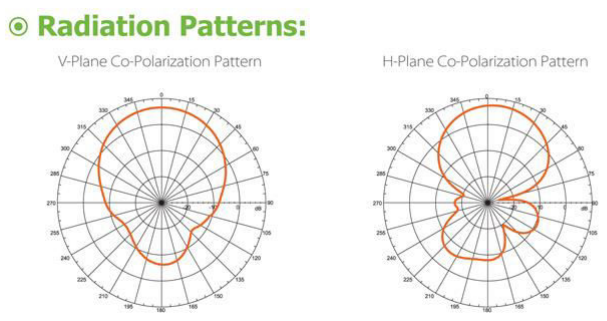
[picture p56: figure]

Presenter: Ali Canpolat | CanSat 2014 PDR: Team #5524 (Team ARISAT) | 87
SPECIFICATION | Tp-link TL-ANT2409A | Tp-Link TL-ANT2405CL | 2.1dB Stock Xbee Antenna
Gain | 9 dB | 5 dB | 2.1 dB
Type | Directional | Omnidirectional | Omnidirectional
Size | 12cmx12cm | 1.3x19 cm | 1.3x10 cm
Price | 22 $ | 2.9 $ | 2 $

### CHOOSEN ANTENNA: Tp-link TL-ANT2409A

(If You Want) | GCS Antenna Trade & Selection

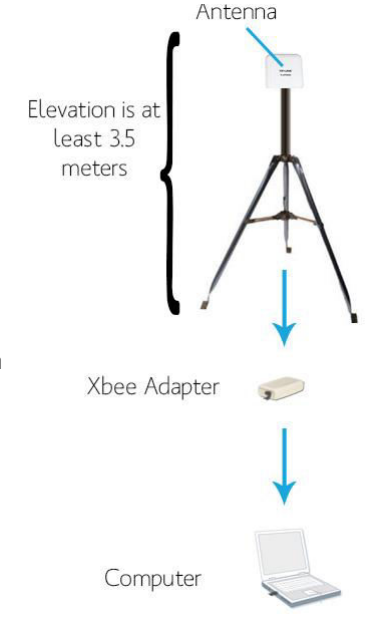
[picture p57: figure]

Presenter: Ali Canpolat | CanSat 2014 PDR: Team #5524 (Team ARISAT) | 88

CHOOSEN ANTENNA: Tp-link TL-ANT2409A

Whe choose this antenna because;
- High gain
- 9 dBi gain is enough for communications range between CanSat and GCS.

Antenna mast height and mounting strategy
- Setup the ground control systems in suitable competition area
- Set antenna with extendable tripod
- Using tape measure, we will verify length of system
Distance link predictions and margins
- Approximate range 1500 meters

(If You Want) GCS Software

### - GCS software will show telemetry data and draw live graphs on screen

### - GCS software will be designed by team members helping with open-source projects. Thus we can optimize the program according to our design requirements

### - After parsing telemetry data, data will be stored in a txt file. These parsed data will be plotted on screen and will be written on .csv telemetry file

CanSat 2014 PDR: Team #5524 (Team ARISAT) | 89

### Telemetry Data

### Via Serial Port

### Data Parser

### Writting on .csv file

### Storing

## data’s

### Showing telemetry data and draw live graphs

Presenter: Ali Canpolat

# CanSat Integration and Test

# Ümit Yelken

CanSat 2014 PDR: Team #5524 (Team ARISAT) | 90

(If You Want)

# CanSat Integration and Test Overview

### - Mechanical

Separation Mechanism:
- We all aggreed that ring-clevis separation system is more safe than any other one.
- We will test under unexpected conditions ( forces and acceleration)
- This tests will be made as soon as the mechanical workouts are done

Egg Drop Test:
- We covered the egg (as in the picture) and we threw it on to ground from different altitudes.
- Depends on several test results we find the best way for egg protection with using polyethylen.
- After finis all cansat mechanism, egg protection will be integrated cansat and we will re-test egg protection on different altitudes.

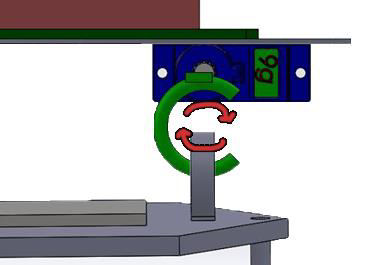
[picture p58: figure]
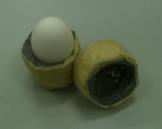
[picture p59: figure]

Presenter: Ümit Yelken | CanSat 2014 PDR: Team #5524 (Team ARISAT) | 91

(If You Want)

# CanSat Integration and Test Overview

### Descent Control:

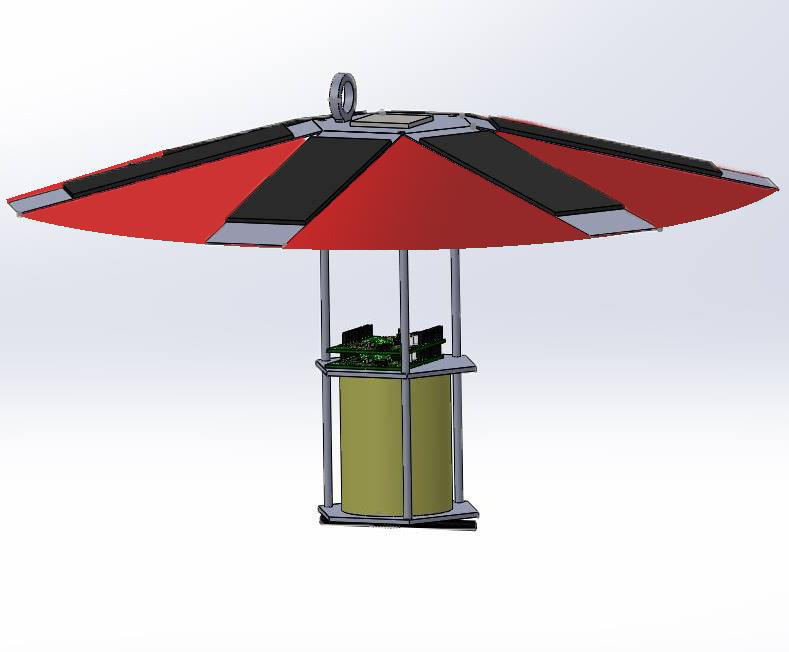
[picture p60: figure]

Container:
- For parachute opening and impact tests we have some options such as release from a quadrocopter, wind tunnel, opening behind a car. We will try all of these options repeatly

Payload:
- Firstly, we will test with only panels without solar panels for opening of the plate.
- Then we will make these tests with for solar panels and we will optimize them with changing sunlight angle depends on energy they havest.
- Finally, we will add the fabrics between the plates to check rate of descent.

After all integrations of cansat subsystems are done,
we will check again the descent rate of the CanSat.
Presenter: Ümit Yelken | CanSat 2014 PDR: Team #5524 (Team ARISAT) | 92

(If You Want)

# CanSat Integration and Test Overview

### - Power / Electrical

– All electronic components are located on a printed circuit board.
– Energy harvest: Solar panels will be tested before integration. According to test results, energy harvest system will be integrated with electrical systems.
– First of all, electrical subsystems will be tested separately. After all subsystems work successfully, electrical subsystems will be integrated with each other and the energy harvest system.
– After integration, electronic system will be tested by using low altitude tests.
- Sensors
– Pressure: The altitude of cansat will be calculated with the pressure sensor. Pressure sensor will be tested on a location, the altitude of which we exactly know.
– Accelerometer: Sensor system will be tested, when the cansat mechanism is ready. – Memory: Sample data will be tested and stored in SD Card. After storing, data needs to be read from the SD Card correctly.
– Voltage monitor: Battery on the container and energy harvest system of payload will be monitered in microcontroller. To do this, voltage divider circuit will be used and will send the voltage data microcontroller via ADC.
Presenter: Ümit Yelken | CanSat 2014 PDR: Team #5524 (Team ARISAT) | 93

(If You Want)

# CanSat Integration and Test Overview

- Communication
- Sample data will be sent for test of communication range. Communication tests will be repeated upon completion of the ground station.
- Sample data needs to be transferred correctly and completely to the ground station.
- Ground Control:
– The data sent from cansat should be accurately received and saved by the ground station. When communication part is ready, ground station will be tested
- Flight Software:
– Will be tested when all electrical subsystems are integrated
- List of major electrical tests:
– Energy harvest test
– Sensor test
– Long distance Communication test
– Monitoring data from ground station test
– Flight software test
Presenter: Ümit Yelken | CanSat 2014 PDR: Team #5524 (Team ARISAT) | 94

# Mission Operations & Analysis

# Eren Durkaya

CanSat 2014 PDR: Team #5524 (Team ARISAT) | 95

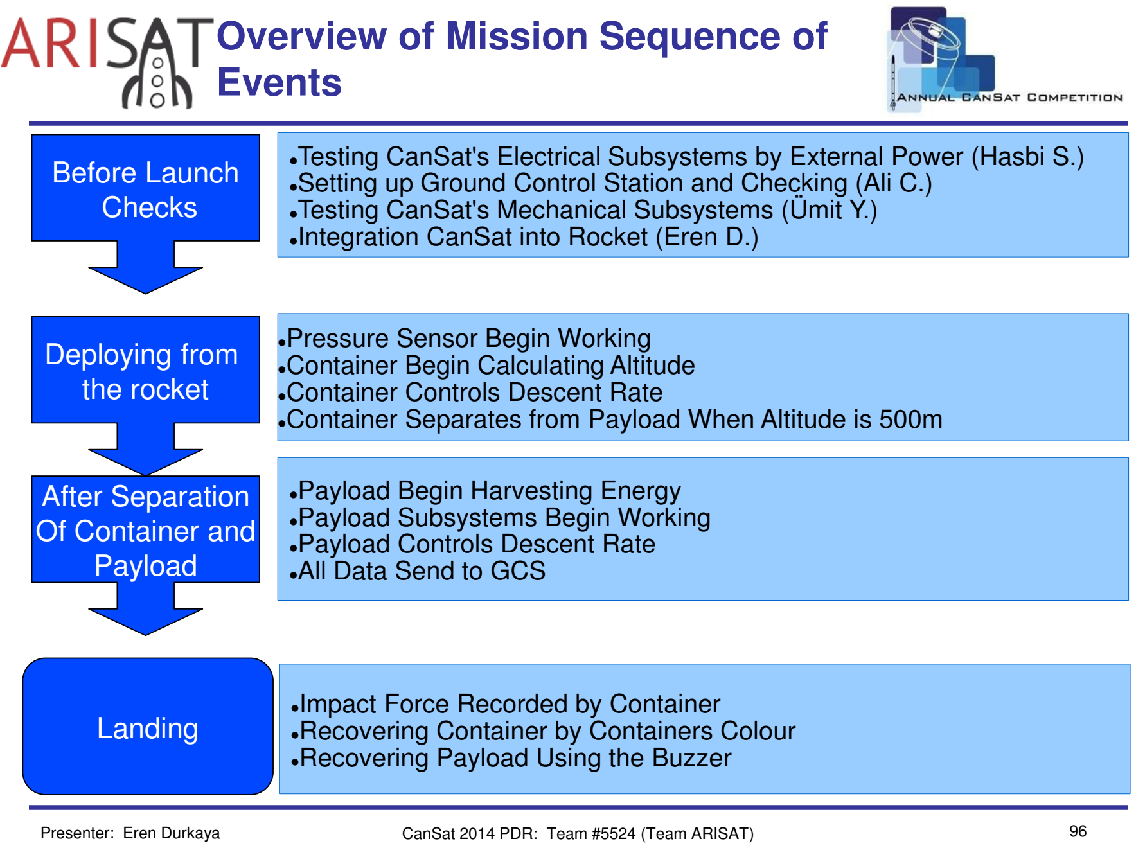
[picture p61: figure]
(If You Want); Overview of Mission Sequence of Events; ●Pressure Sensor Begin Working ●Container Begin Calculating Altitude ●Container Controls Descent Rate; ●Impact Force Recorded by Container ●Recovering Container by Containers Colour ●Recovering Payload Using the Buzzer; ●Payload Begin Harvesting Energy ●Payload Subsystems Begin Working ●Payload Controls Descent Rate ●All Data Send to GCS; Landing; Before Launch Checks; Deploying from the rocket; After Separation Of Container and Payload

●Testing CanSat's Electrical Subsystems by External Power (Hasbi S.) ●Setting up Ground Control Station and Checking (Ali C.)
●Testing CanSat's Mechanical Subsystems (Ümit Y.)
●Integration CanSat into Rocket (Eren D.)

●Container Separates from Payload When Altitude is 500m

Presenter: Eren Durkaya | CanSat 2014 PDR: Team #5524 (Team ARISAT) | 96

(If You Want)

# Overview of Mission Sequence of Events

After Landing | ●Checking Egg for Damage (Emre E.) ●Checking for being Sure Nothing Left in the Field (Team)
Analysing | ●Analysing Data that GCS Recieved from Payload (Team) ●Analysing Data in Container via USB Connection (Team)

### Post Flight Review

●Using Informations about Flight Preparing a Presentation ●Presenting the Post Flight Presentation to Participants

Presenter: Eren Durkaya | CanSat 2014 PDR: Team #5524 (Team ARISAT) | 97

(If You Want)

# Mission Operations Manual Development Plan

CanSat 2014 PDR: Team #5524 (Team ARISAT) | 98

On Mission Operation Manuel Developement Plan

- Team manual of cansat
- Mission controller list
- Station set-up instructions

Operation Manual Developement Plan

- Documentation of cansat design being revised now
- Program schedule of competition
- Operation instruction

Presenter: Eren Durkaya

(If You Want) | CanSat Location and Recovery
CanSat 2014 PDR: Team #5524 (Team ARISAT) | 99

### - Container Recovery:

- We will use the sensor and GPS values transmitted between the launch and the deployment of the Container to estimate the horizontal speed of the Cansat.
- Container will have a horizontal speed with variable direction depends on wind.
- We will write our analysis software for this.
- Container will have Orange colour to find it easily

### - Payload Recovery:

- We will make estimations about the location of Payload using the transmitted GPS data from container, the direction of its horizontal speed calculated using transmitted data.
- Payload will have loud buzzers activated after landing thus finding them should not be hard.
- Payload will have Orange colour to find it easily

Presenter: Eren Durkaya

# Requirements Compliance

# Eren Durkaya

CanSat 2014 PDR: Team #5524 (Team ARISAT) | 100

# (If You Want) Requirements Compliance Overview

## - In general, content of the detailed slides that follow includes base

## requirements which are about structure properties, mechanical

## subsystems, communication and data handling, electrical power

## systems, flight software design, ground station system design, mission

operation and management.

## - All subsystem designs were finished, sensors were tested, flight

## software algorithms were created, structural and mechanical

## subsystems were completed and descent and ground station systems

were designed. To sum up, many base requirements are satisfied.

## - The ground station will be completed soon so all base requirements will

be satisfied in little time.

Presenter: Eren Durkaya | CanSat 2014 PDR: Team #5524 (Team ARISAT) | 101

(If You Want) | Requirements Compliance
CanSat 2014 PDR: Team #5524 (Team ARISAT) | 102
Rqmt Num | Requirement | Comply / No Comply / Partial | X-Ref Slide(s) Demonstrating Compliance | Team Comments or Notes
1 | Total mass of CanSat, container, and payload shall be 600 grams +/-10 grams without the egg | Partial | x, y, z | Using materials are specified. Essential arrengements are going to be done when cansat is prepared.
2 | The payload shall contain and protect the egg . The egg will weigh not more than 67 grams. | Comply | Covering egg | Everything is comply
3 | The payload shall be completely contained in the container. No part of the payload may extend beyond the container. | Comply | Structure | Payload is designed conveniently to container.
4 | Container shall fit in the envelope of 125 mm x 310 mm including the container passive descent control system. Tolerances are to be included to facilitate container deployment from the rocket fairing. | Comply | Structure | Container is designed according to the rocket and it will be produced.
5 | The container shall use a passive descent control system. It cannot free fall. | Comply | Descent Control | The container has a passive descent control system.
6 | The container must be a florescent color, pink or orange. | Comply | Locating | Orange color is selected

Presenter: Eren Durkaya

(If You Want) | Requirements Compliance
Rqmt. Num. | Requirement | Comply / No Comply / Partial | X-Ref Slide(s) Demonstrating Compliance | Team Comments or Notes
7 | The container shall not have any sharp edges to cause it to get stuck in the rocket fairing section. | Comply | Deploying | The container have not any sharp edges.
8 | The rocket airframe shall not be used as part of the CanSat operations or to restrain any deployable parts of the CanSat. | Comply | Structure | Any parts of CanSat are not restrained by rocket airframe.
9 The CanSat (container and payload) shall | deploy from the rocket fairing section. | Comply | Structure | Everything is comply
10 The descent control systems shall not use | any flammable or pyrotechnic devices. | Comply | Security | Everything is comply
11 | The descent rate of the CanSat shall be 12 m/s above 500 meters. | Comply | Descent Control | The descent system was designed according to these datas.
12 | When the CanSat reaches 500 meters, the payload shall be released from the container. | Comply | Ring-clevis design | Design is completed, it is ready for production and tests.
Presenter: Eren Durkaya | CanSat 2014 PDR: Team #5524 (Team ARISAT) | 103

(If You Want) | Requirements Compliance
Rqmt. Num | Requirement | Comply / No Comply / Partial | X-Ref Slide(s) Demonstrating Compliance | Team Comments or Notes
13 | When released, the payload shall have a descent rate of less than 10 m/s. | Comply | Descent control | Payload descent system is completed and it will be tested when CanSat will be finished.
14 | All descent control device attachments shall survive 30 Gs of shock. | Partial | Durability | it will be tested when CanSat will be finished.
15 | All descent control devices shall survive 30 Gs of shock. | Partial | Durability | it will be tested when CanSat will be finished.
16 | All electronic components shall be enclosed and shielded from the environment with the exception of sensors. | Comply | Structure | Everything is comply.
17 | All structures shall be built to survive 15 Gs acceleration. | Partial | Durability | it will be tested when CanSat will be finished.
18 | All structures shall be built to survive 30 Gs of shock. | Partial | Durability | it will be tested when CanSat will be finished.
Presenter: Eren Durkaya | CanSat 2014 PDR: Team #5524 (Team ARISAT) | 104

(If You Want) | Requirements Compliance
Rqmt. Num. | Requirement | Comply / No Comply / Partial | X-Ref Slide(s) Demonstrating Compliance | Team Comments or Notes
19 | All electronics shall be hard mounted using proper mounts such as standoffs, screws, or high performance adhesives. | Comply | Structure
20 | All mechanisms shall be capable of maintaining their configuration or states under all forces. | Comply | Structure | All mechanisms are durable under all forces.
21 | Mechanisms shall not use pyrotechnics or chemicals. | Comply | Security
22 | Mechanisms that use heat (e.g., nichrome wire) shall not be exposed to the outside environment to reduce potential risk of setting vegetation on fire. | Comply | Security
23 | No batteries shall be allowed in the payload. Batteries are allowed only in the container to support releasing the payload. | Comply | Concept | The energy harvesting system was finished for payload.
Presenter: Eren Durkaya | CanSat 2014 PDR: Team #5524 (Team ARISAT) | 105

(If You Want) | Requirements Compliance
Rqmt. Num. | Requirement | Comply / No Comply / Partial | X-Ref Slide(s) Demonstrating Compliance | Team Comments or Notes
24 | The container shall only use alkaline type batteries. | Comply | Security | The battery is selected.
25 | The container shall collect and store altitude data at a 1 Hz rate from launch to the moment of landing. | Partial | Electrical | All of sensors was tested and ready for combination.
26 | The container shall transmit its altitude data at a 1 Hz rate during from launch time to landing. | Comply | Electrical | The distance tests is continuing.
27 | The payload shall harvest energy from the environment during descent. | Comply | Electrical | The energy harvesting system was finished for payload.
28 | During descent, the payload shall collect air pressure, air temperature and power source voltage once per second. | Comply | Electrical | All of sensors was tested and ready for combination.
Presenter: Eren Durkaya | CanSat 2014 PDR: Team #5524 (Team ARISAT) | 106

(If You Want) | Requirements Compliance
Rqmt. Num | Requirement | Comply / No Comply / Partial | X-Ref Slide(s) Demonstrating Compliance | Team Comments or Notes
29 | During descent, the payload shall transmit all telemetry. The number of telemetry data transmitted shall be scored. The payload shall not generate telemetry at greater than 1 Hz rate. | Comply | Electrical
30 | Telemetry shall include payload mission time with one second or better resolution, which begins when the payload is powered on. Mission time shall be maintained in the event of a processor reset during the launch and mission. | Partial | Electrical | We have wrote our software accomplish this requirement
31 | XBEE radios shall be used for telemetry. 2.4 GHz Series 1 and 2 radios are allowed. 900 MHz XBEE Pro radios are also allowed. | Comply | Electrical
32 | XBEE radios shall have their NETID/PANID set to their team number. | Comply | Electrical
Presenter: Eren Durkaya | CanSat 2014 PDR: Team #5524 (Team ARISAT) | 107

(If You Want) | Requirements Compliance
Rqmt. Num | Requirement | Comply / No Comply / Partial | X-Ref Slide(s) Demonstrating Compliance | Team Comments or Notes
33 | XBEE radios shall not use broadcast mode. | Comply | Electrical
34 | Both the container radio and payload radio shall use the same NETID/PANID. | Comply | Electrical
35 | The payload shall include an external umbilical power connection to allow for testing and safety checks when not harvesting energy. | Comply | Electrical | external umbilical power connection system was finished.
36 | The external power connection shall be a sturdy connector that is easily accessible when the payload is stowed in the container. Loose wires are not allowed. | Comply | Mechanical
37 | Cost of the CanSat shall be under $1000. Ground support and analysis tools are not included in the cost. | Comply | Management
Presenter: Eren Durkaya | CanSat 2014 PDR: Team #5524 (Team ARISAT) | 108

(If You Want) | Requirements Compliance
Rqmt. Num. | Requirement | Comply / No Comply / Partial | X-Ref Slide(s) Demonstrating Compliance | Team Comments or Notes
38 | Each team shall develop their own ground station. | Partial | Mechanical | It is decided to how the ground station will be made and it will be finished soon.
39 | All telemetry shall be displayed in real time during descent. | No Comply | Electrical | İt will be tested after the ground station will be completed.
40 | All telemetry shall be displayed in engineering units (meters, meters/sec, Celsius, etc.) | Comply | Electrical | All telemetry will be display in engineering units.
41 | Teams shall plot data in real time during flight. | No Comply | Electrical | İt will be made after the ground station will be completed.
42 | The ground station shall include an antenna mast of 3.5 meters height, which is to be measured from the ground to the tip of the antenna structure. | Comply | Mechanical
Presenter: Eren Durkaya | CanSat 2014 PDR: Team #5524 (Team ARISAT) | 109

(If You Want) | Requirements Compliance
Rqmt. Num. | Requirement | Comply / No Comply / Partial | X-Ref Slide(s) Demonstrating Compliance | Team Comments or Notes
43 | The ground station mast shall be free standing. The antenna mast cannot be attached to provided tent or other structures. | Comply | Mechanical
44 | The ground station mast shall be properly secured as to not fall over under any conditions with surface winds up to 30 mph. | Comply | Mechanical
45 | If guy wires are used to support the ground station antenna mast, the guy wires shall be made visible for safety. | Comply | Security
46 | Both the container and payload shall be labeled with team contact information including email address. | Comply | Recovery
Presenter: Eren Durkaya | CanSat 2014 PDR: Team #5524 (Team ARISAT) | 110

(If You Want) | Requirements Compliance
Rqmt. Num. | Requirement | Comply / No Comply / Partial | X-Ref Slide(s) Demonstrating Compliance | Team Comments or Notes
47 | The flight software shall maintain a count of packets transmitted, which shall increment with each packet transmission throughout the mission. The value shall be maintained through processor resets. | Partial | Electrical | It is thought that how it will be made and it will be completed after the electronic system of CanSat will be finished.

48

The container and payload shall maintain a mission time which is the number of seconds since each vehicle is powered on. The mission time shall be maintained in the event of a power loss or processor reset. The time may be maintained by software or by hardware real-time clock. If a hardware real-time clock is used, a separate, dedicated power source may be used to power the clock; however, this power source may not be used to power any other vehicle functions.

Comply | Electrical
A hardware real-time
clock will be used
Presenter: Eren Durkaya | CanSat 2014 PDR: Team #5524 (Team ARISAT) | 111

# Management

# Hasbi Sevinç

CanSat 2014 PDR: Team #5524 (Team ARISAT) | 112

(If You Want) | CanSat Budget – Hardware
Presenter: Hasbi Sevinç | CanSat 2014 PDR: Team #5524 (Team ARISAT) | 113
Components | Model | Quantity | Unit Price | Price Definition
Pressure and Temperature Sensor (Container and Payload) | BMP-085 | 2 | $19.95 | Actual
Accelerometer (Payload) | ADXL345 | 1 | $27.95 | Actual
GPS (Container) | LS20031 | 1 | $59.95 | Actual
Microcontroller (Container and Payload) | ATmega2560 | 2 | $16 | Actual
Buzzer (Container and Payload) | ADL | 2 | $5 | Actual
SuperCapacitor (Payload) | Lampson | 2 | $4 | Actual
Solar Panel (Payload) | Solar Pocket Factory | 6 | $10 | Actual
Battery (Container) | Energizer HighTech | 1 | $3 | Actual
XBEE Module (Container and Payload) | Xbee pro 2.4 ghz | 2 | $40 | Actual
Custom PCB (Container and Payload) | - | 2 | $100 | Estimate
Servo (Container) | Tower Pro SG92R | 1 | $3 | Actual
Descent Control System (Payload) | - | - | $35 | Estimate
Parachute (Container) | - | 1 | $25 | Estimate
Structure Materals (Container and Payload) | - | - | $50 | Estimate
Egg Protection (Payload) | - | - | $5 | Estimate
SUBTOTAL | | | | $638.8

Electronic

MECHANİC

(If You Want) | CanSat Budget – Other Costs
Presenter: Hasbi Sevinç | CanSat 2014 PDR: Team #5524 (Team ARISAT) | 114
Components | Model | Quantity | Unit Cost | Price Definition
Antenna Cable | Tp-link TL-ANT2409A | 1 | $22 | Actual
XBEE Module | Xbee pro 2.4 ghz | 1 | $40 | Actual
Mounting hardware | - | 1 | $25 | Estimate
SUBTOTAL | | | | $87
Category | Quantity | Unit Price | Price Definition
Prototyping & Testing | - | $250 | Estimated
Travel | 7 person | $900 | Estimated
Hotel | 3 days | $150 | Estimated
Food | 7 person | $75 | Estimated
SUBTOTAL | | | $7525

## Ground System Costs

## Other Costs

(If You Want) | CanSat Budget – Total Costs

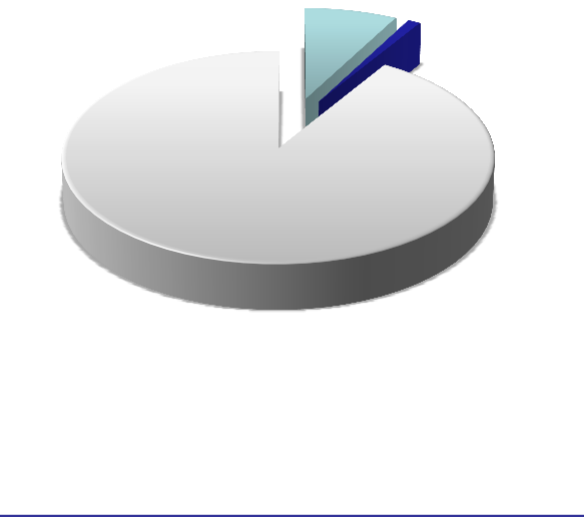
[picture p62: figure]

Presenter: Hasbi Sevinç | CanSat 2014 PDR: Team #5524 (Team ARISAT) | 115
Description | Price($)
Hardware | $638.8
Ground System Costs | $87
Other Costs | $7525
Total Cost | $8250.8

## Total Costs

### Hardware

### Ground System Other

### The total funding we receive from

the University is $7000.

### We are currently in search of new

sponsors.

(If You Want) | Program Schedule
DATE | Mechanics | Electronics | Managements | Academic Schedule | High Level Task
September (1-15 days) | - | - | Finding team members | Beginning of first term | Team comes together
September (15-31 days) | - | - | Finding team members
October (1-15 days) | Gathering and reviewing information about competition | Gathering and reviewing information about competition | Gathering and reviewing information about competition | Quizes Homeworks | Gathering and reviewing information about competition tasks and Cansat systems
October (15-31 days) | Reviewing mechanic structures of previous CanSats | Reviewing electronic structures of previous CanSats
November (1-15 days) | Designing mechanic systems | Designing electronic systems & purchase of components | | Midterms | Subsystems design
November (15-30 days) | Purchasing materials | Testing sensors, RF and GPS systems | | | Testing subsystems
December (1-15 days) | Testing egg protection system
(15-31 days) | Brainstorm for energy harvest system | Brainstorm for energy harvest system | Gathering information for PDR | Homeworks December | Designing energy harvest system

Searching for
Sponsorship

Quizes

Presenter: Hasbi Sevinç | CanSat 2014 PDR: Team #5524 (Team ARISAT) | 116

(If You Want) | Program Schedule
DATE | Mechanics | Electronics | Managements | Academic Schedule | High Level Task
January (1-15 days) | Preparing PDR | Preparing PDR | Preparing PDR | Final Exams | Preparing PDR
January (15-31 days) | Preparing PDR | Preparing PDR | Preparing PDR | Winter Break
February (1-15 days) | Lookink for Sponsorship | Lookink for Sponsorship | Searching for test area | | Lookink for Sponsorship
February (15-28 days) | Testing descent systems | Preparation of ground system and software | Buying flight tickets | Beginning of second term | Producing the cansat prototype
March (1-15 days) | Putting together subsystems | Testing energy harvest | Preparing CDR | Quizes Homeworks
March (15-31 days) | Testing cansat mechanics | Putting together subsystems | Preparing CDR
April (1-15 days) | Putting together Cansat mechanics and electronics | Putting together Cansat mechanics and electronics | Hotel reservations and Visa applications | Exams | Testing Subsystems and all cansat systems
April (15-30 days) | Testing Cansat | Testing Cansat
Presenter: Hasbi Sevinç | CanSat 2014 PDR: Team #5524 (Team ARISAT) | 117

(If You Want) | Program Schedule
DATE | Mechanics | Electronics | Managements | Academic Schedule | High Level Task
May (1-15 days) | Evaluation of tests | Evaluation of tests | - | Quizes Homeworks | Evaluation of tests for the final check
May (15-31 days) | Final checks | Final checks | Final checks | Final Exams
June | Cansat Competition | Cansat Competition | Cansat Competition | - | Participating in the Cansat Competition
Presenter: Hasbi Sevinç | CanSat 2014 PDR: Team #5524 (Team ARISAT) | 118

(If You Want) Conclusions

### Major accomplishments

- Team is built up
- A good understanding of the mission requirements acquired
- Subsystems are designed
- Materials and components are selected
- Sensors and RF systems are tested
- Descent and energy harvest systems are designed

### Major unfinished work

- PCB design will be produced
- Software will be improved
- Cansat protype will be produced
- Cansat will be tested

Electronic and mechanic subsystems are ready for production and integration. Therefore, the next stage involves the production and integration of all subsystems.

Presenter: Hasbi Sevinç | CanSat 2014 PDR: Team #5524 (Team ARISAT) | 119
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
