julian0821/KAIOS/CANSAT/DOCUMENTACION/CANSAT - KAIOS/Imágenes de otros CANSAT/Cansat (1).jpg

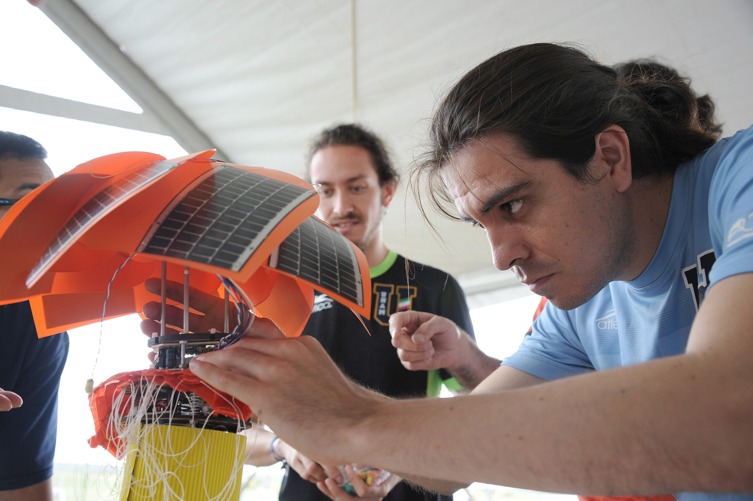
CANSAT/DOCUMENTACION/CANSAT - KAIOS/Imágenes de otros CANSAT/Cansat (1).jpg
