julian0821/KAIOS/CANSAT/DOCUMENTACION/CANSAT - KAIOS/Imágenes de otros CANSAT/Cansat (2).jpeg

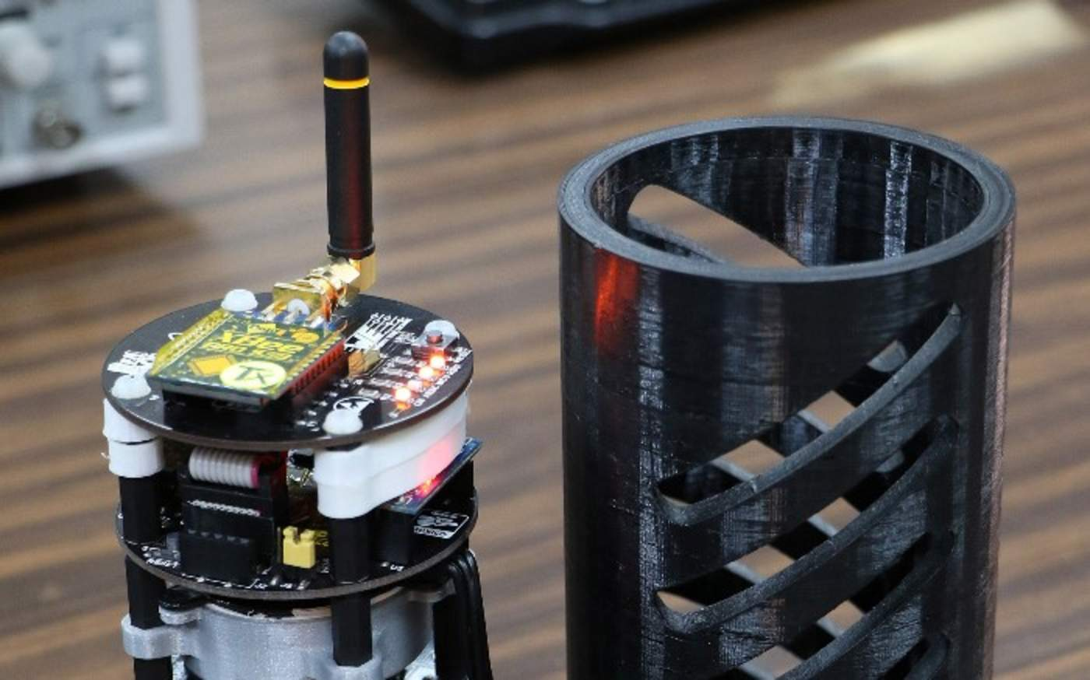
CANSAT/DOCUMENTACION/CANSAT - KAIOS/Imágenes de otros CANSAT/Cansat (2).jpeg
