julian0821/KAIOS/CANSAT/DOCUMENTACION/CANSAT - KAIOS/Imágenes de otros CANSAT/Cansat (3).jpeg

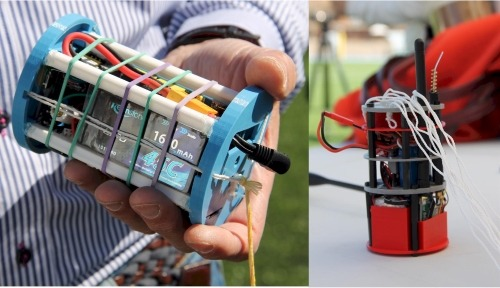
CANSAT/DOCUMENTACION/CANSAT - KAIOS/Imágenes de otros CANSAT/Cansat (3).jpeg
