julian0821/KAIOS/Componentes/Documento sin título.docx

RFM95W

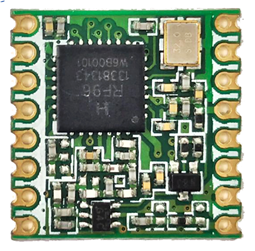
[picture p87: figure]

Controlador de la antena

ADXL345

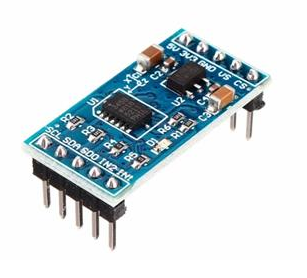
[picture p88: figure]

Acelerómetro

gm

BMP180/280

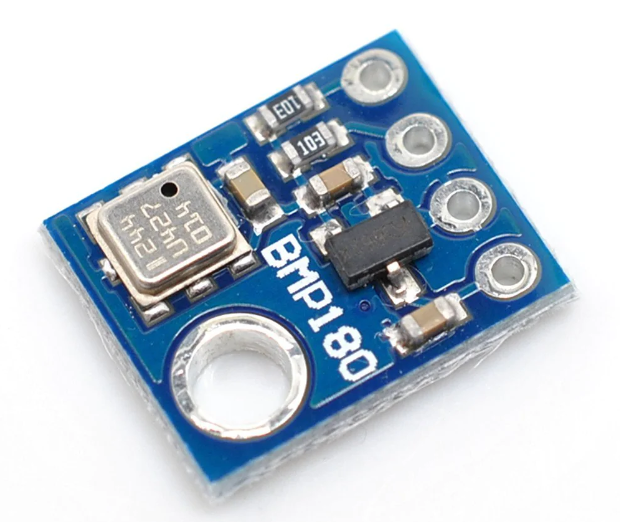
[picture p89: figure]

Sensor de presión y temperatura

BLUEPILL (STM32)

Microprocesador principal

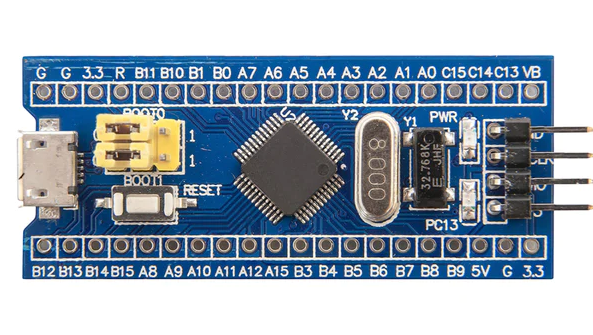
[picture p90: figure]
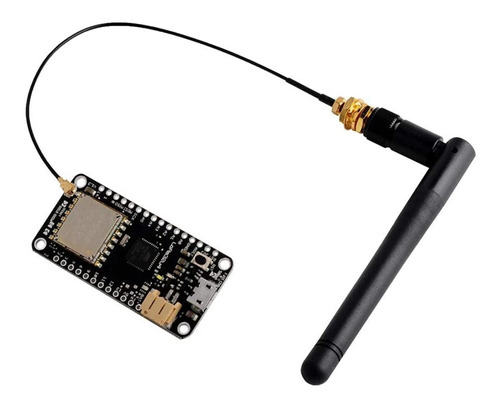
[picture p91: figure]

LORA 32U4 II + Antena

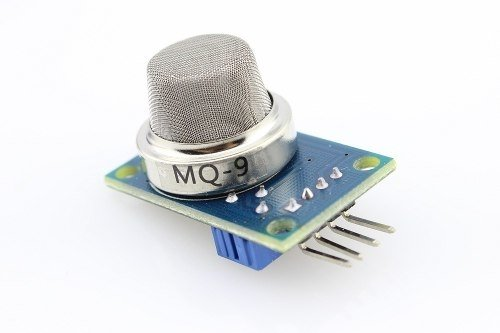
[picture p92: figure]

MQ-9

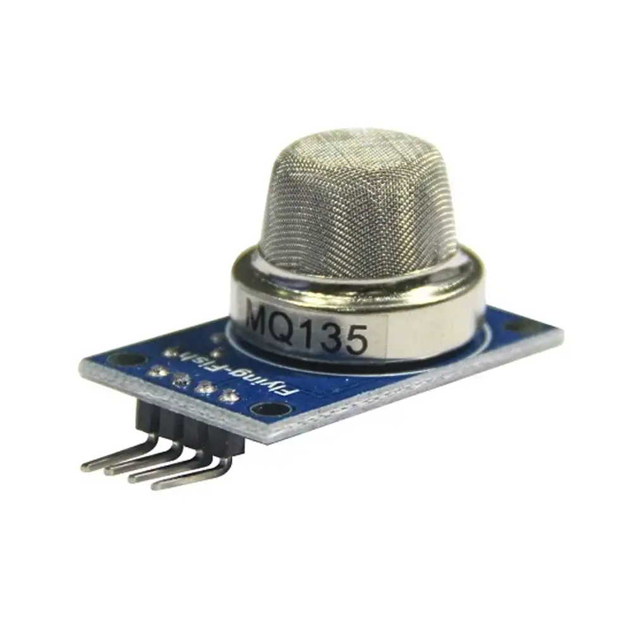
[picture p93: figure]

MQ135

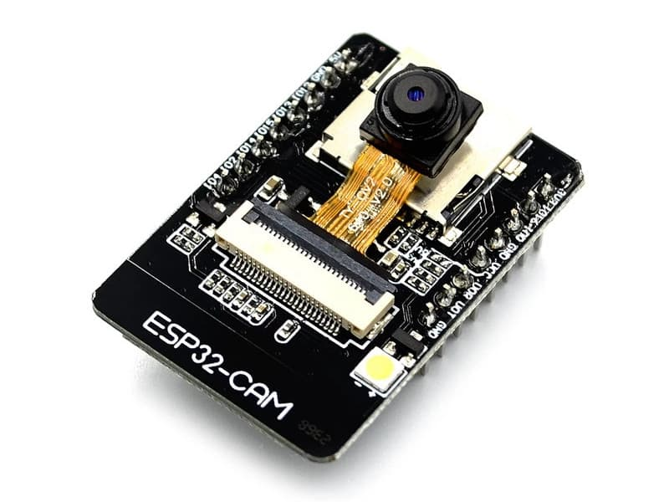
[picture p94: figure]

ESP32 CAM
