julian0821/KAIOS/CANSAT/DOCUMENTACION/CANSAT - KAIOS/Componentes/Componentes.docx

RFM95W


Controlador de la antena

ADXL345


Acelerómetro

gm

BMP180/280


Sensor de presión y temperatura

BLUEPILL (STM32)

Microprocesador principal


LORA 32U4 II + Antena


MQ135


ESP32 CAM
