julian0821/KAIOS/Componentes/Precios.xlsx

Componente | Peso | Precio
LORA 32U4 II | 20g | 7400
BMP180 | 3g | 300
Bateria LiPo | 12g | 600
STM32 | 20g | 1900
ADXL345 | 6g | 500
MQ135 | 7.7g | 600
RFM95W |  | 205
ESP32 CAM | 20g | 2250
MQ-9 | 10g | 570
GY-8511 ML8511 |  | 2000
