julian0821/KAIOS/CANSAT/pcbs/cansat.kicad_pcb

## KiCad design CANSAT/pcbs/cansat.kicad_pcb (2022-07-06)

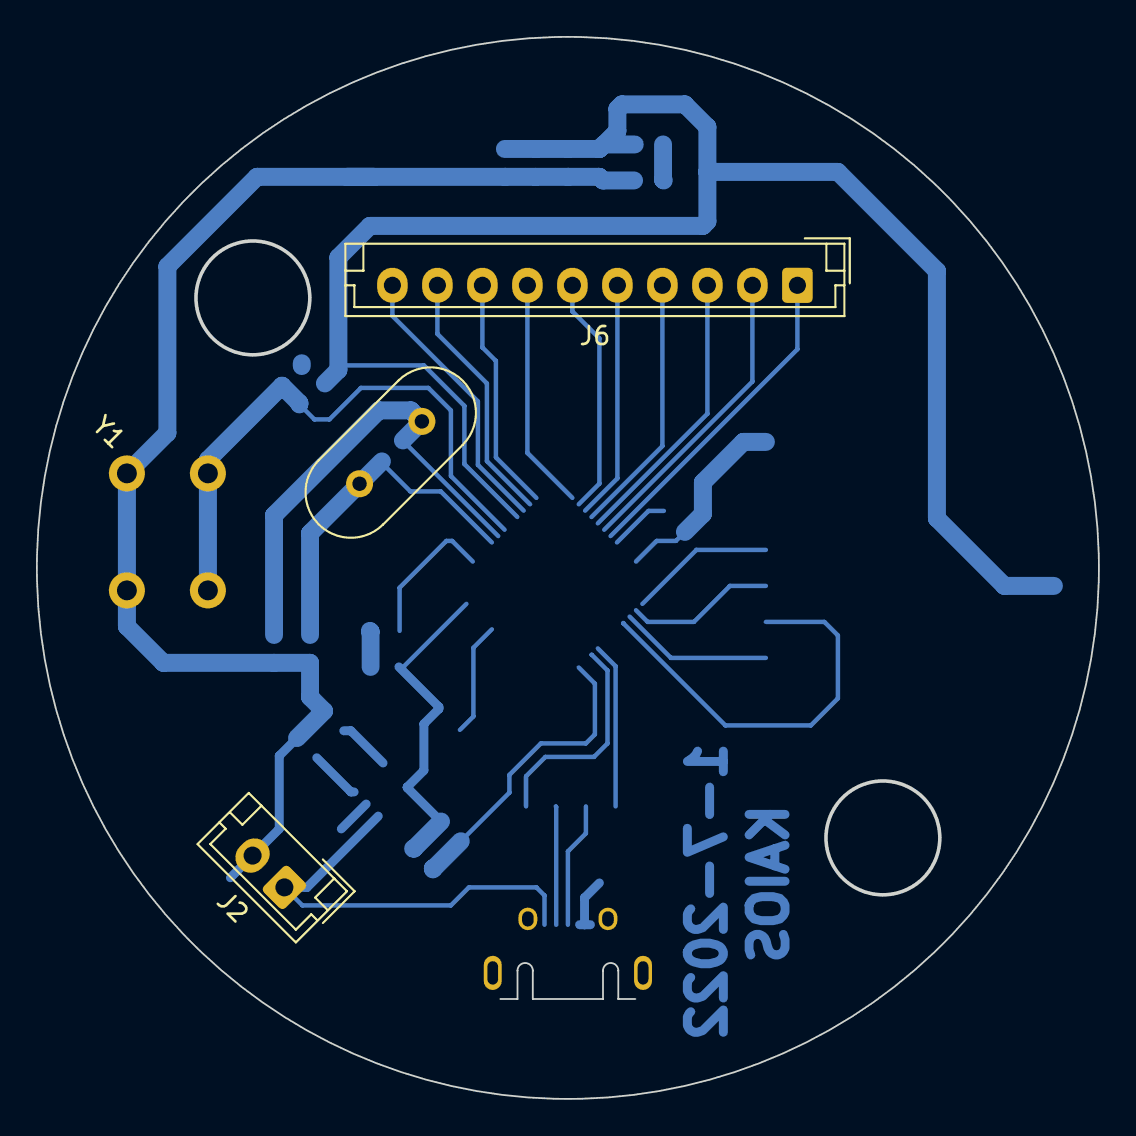
[picture p95: board cansat.kicad_pcb from above]

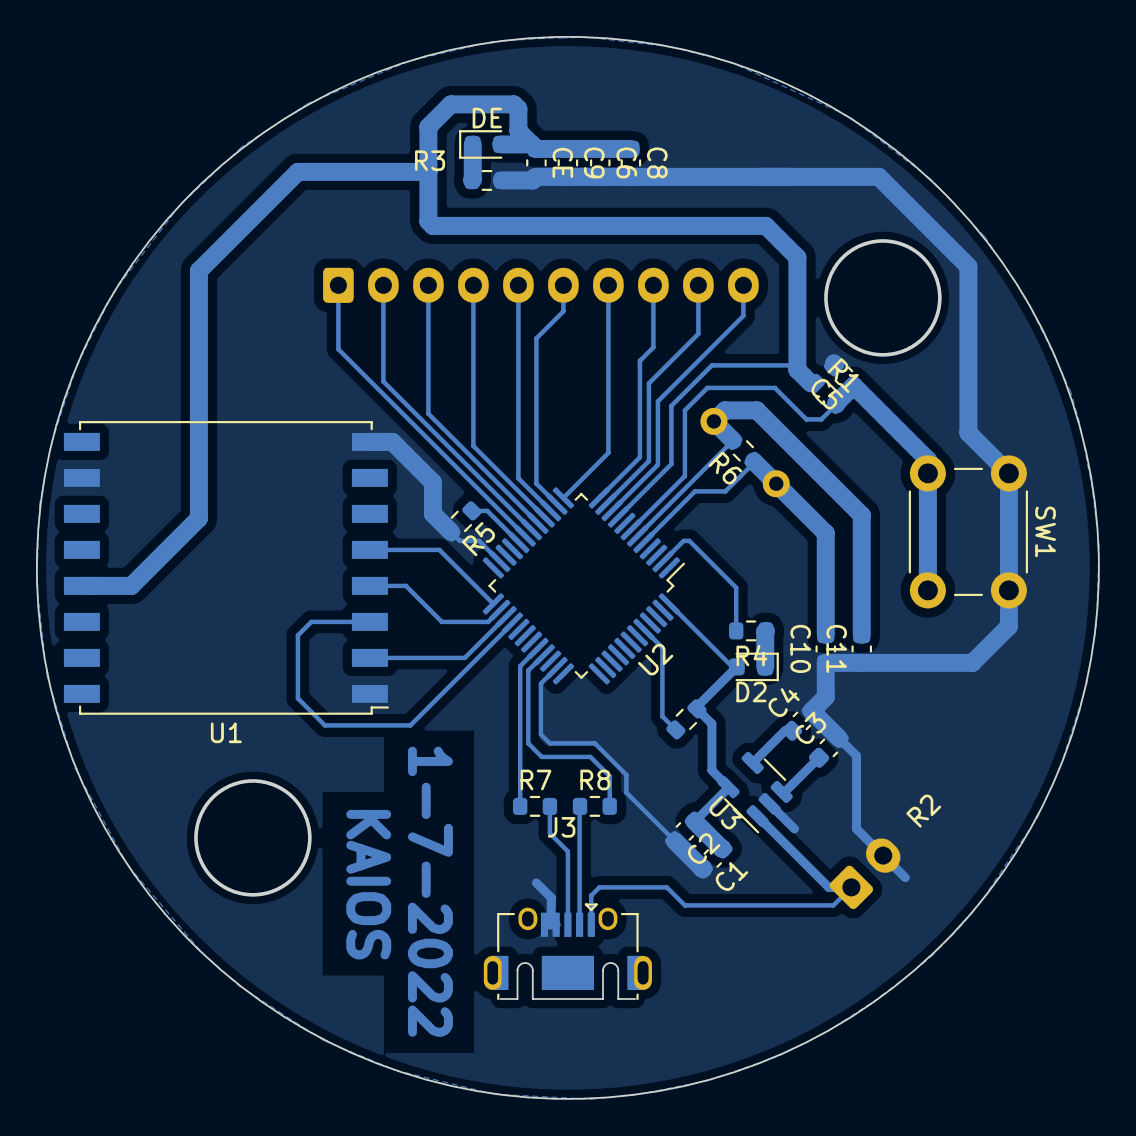
[picture p96: board cansat.kicad_pcb from below]

Board: 2 copper layers, 59.0 x 59.0 mm, 29 parts (26 on the bottom side), 30 nets.

Parts:
C1: 106u; C_0603_1608Metric
C2, C6, C8, C9: 104u; C_0603_1608Metric
C3, C5: 105u; C_0603_1608Metric
C4: 223u; C_0603_1608Metric
C10, C11: 20p; C_0603_1608Metric
CE: 104u; C_0603_1608Metric
D2: LED; LED_0603_1608Metric
DE: LED; LED_0603_1608Metric
J2: Battery; JST_EH_B2B-EH-A_1x02_P2.50mm_Vertical
J3: USB_B_Micro; USB_Micro-AB_Molex_47590-0001
J6: Conn_01x10; JST_EH_B10B-EH-A_1x10_P2.50mm_Vertical
R1: 10K; R_0603_1608Metric
R2, R5, R7, R8: 100K; R_0603_1608Metric
R3, R4: 510; R_0603_1608Metric
R6: 1M; R_0603_1608Metric
SW1: SW_Push; SW_PUSH_6mm
U1: RFM95W-868S2; HOPERF_RFM9XW_SMD
U2: STM32F103C8T6; LQFP-48_7x7mm_P0.5mm
U3: RT9193-33; TSOT-23-5
Y1: 8M; Crystal_HC18-U_Vertical

Connections:
/3V3: C1.1, C2.1, C6.1, C8.1, C9.1, CE.1, D2.2 (A), DE.2 (A), R1.1, R2.1, U1.13 (3.3V), U2.9 (VDDA), U2.24 (VDD), U2.36 (VDD), U2.48 (VDD), U3.5 (VOUT)
/5V: C3.1, J2.1, J3.1 (VBUS), U3.1 (VIN), U3.3 (EN)
/A0: J6.10, U2.10 (PA0)
/A1: J6.9, U2.11 (PA1)
/A2: J6.8, U2.12 (PA2)
/A3: J6.7, U2.13 (PA3)
/A4: J6.6, U2.14 (PA4)
/A5: J6.5, U2.15 (PA5)
/A6: J6.4, U2.16 (PA6)
/A7: J6.3, U2.17 (PA7)
/B0: J6.2, U2.18 (PB0)
/B1: J6.1, U2.19 (PB1)
/BOOT0: R2.2, U2.44 (BOOT0)
/BOOT1: R5.1, U2.20 (PB2)
/MISO: U1.2 (MISO), U2.27 (PB14)
/MOSI: U1.3 (MOSI), U2.28 (PB15)
/NSS: U1.5 (NSS), U2.25 (PB12)
/OSC_IN: C10.2, R6.1, U2.5 (PD0), Y1.1
/OSC_OUT: C11.2, R6.2, U2.6 (PD1), Y1.2
/PA11: R7.1, U2.32 (PA11)
/PA12: R8.2, U2.33 (PA12)
/PC13: R4.2, U2.2 (PC13)
/RESET: C5.1, R1.2, SW1.2, U2.7 (NRST)
/SCK: U1.4 (SCK), U2.26 (PB13)
GND: C1.2, C2.2, C3.2, C4.2, C5.2, C6.2, C8.2, C9.2, C10.1, C11.1, CE.2, J2.2, J3.4 (ID), J3.5 (GND), R3.2, R5.2, SW1.1, U1.1 (GND), U1.8 (GND), U1.10 (GND), U2.8 (VSSA), U2.23 (VSS), U2.35 (VSS), U2.47 (VSS), U3.2 (GND)
unnamed: C4.1, U3.4 (BP)
unnamed: DE.1 (K), R3.1
unnamed: D2.1 (K), R4.1
unnamed: J3.2 (D-), R8.1
unnamed: J3.3 (D+), R7.2
